ttoomat/work-2026-itmo/README.md

# work-2026-itmo
The first project: DNA synthesiser, power board.

Class B & class D amplifier AI schematics added. Task: remake it manually & start PCB.
