ttoomat/work-2026-itmo/DNA/class_B/LTspice/readme.txt

Draft 1 - для проекта по принтеру ДНК.

Делаю усилитель B класса. Сначала сказано промоделировать с идеальным ОУ в первом
каскаде, подать нужной формы сигнал на вход и посмотреть, какие токи будут в 
выходном каскаде.

Итак, Draft 1 - это просто для ВАХ.

Draft 2 - полная схема усилителя класса B. Точно правильно работает первый каскад. V_IN: [0, 2.5V], V_OUT: [-4.11, 4.13] - усиление в 3.3 раза. V_REF=5V. Добавлен компенсирующий конденсатор, фильтр.

При моделировании с реальным сигналом компенсирующий конденсатор из ООС пришлось удалить. Входной сигнал берётся из файла signal_pwl.txt

Draft 3 - инвертирующий усилитель на транзисторе (для проверки, правильно ли работает LTSpice).
