ttoomat/work-2026-itmo/DNA/class_B/AI/preview/04.png

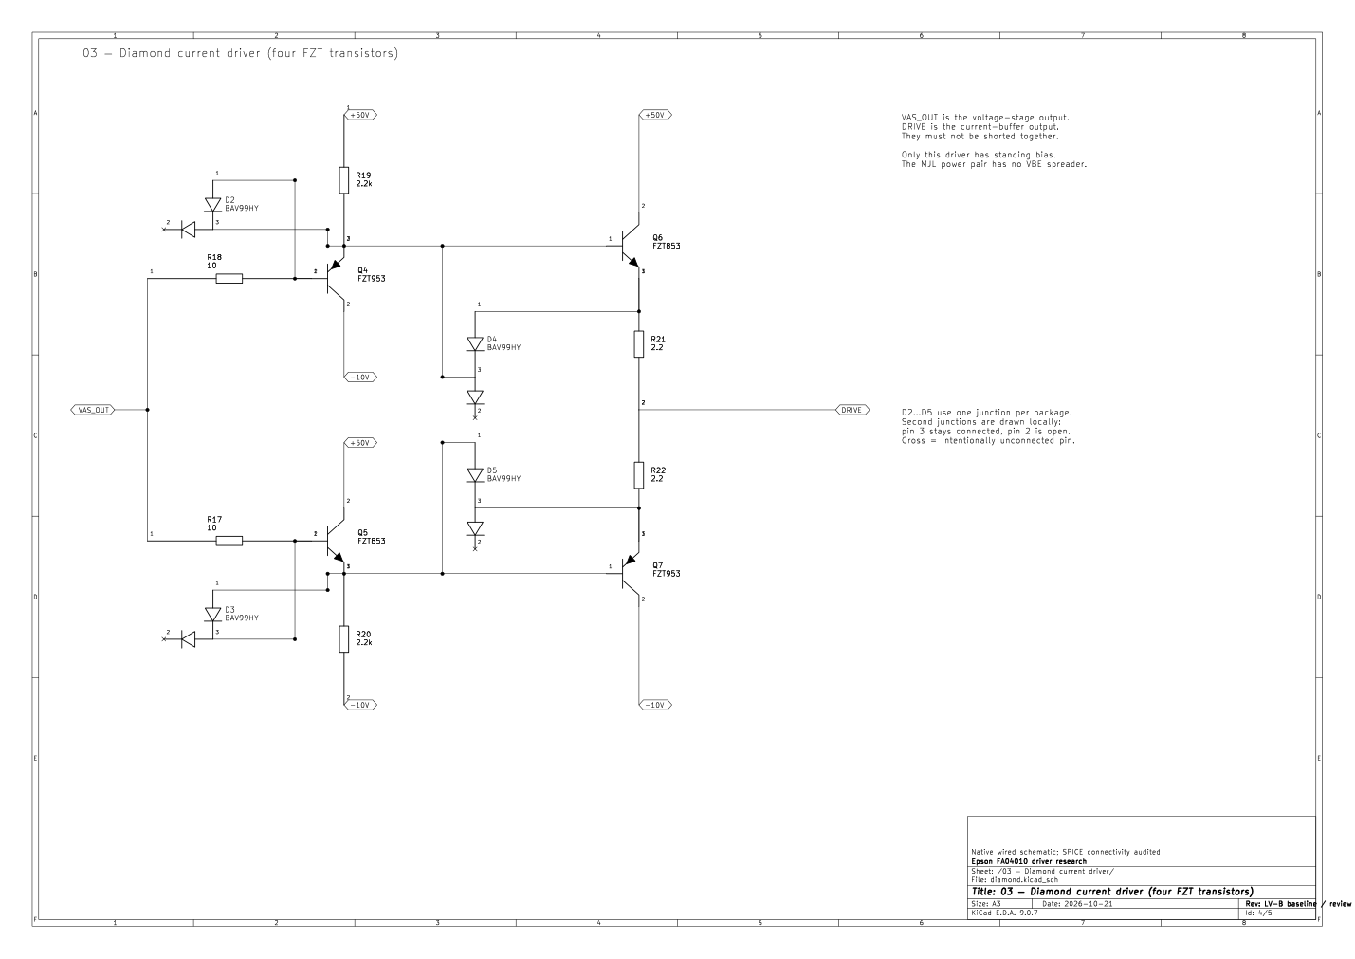
DNA/class_B/AI/preview/04.png
