ttoomat/work-2026-itmo/DNA/class_B/AI/spice/last_pulse.png

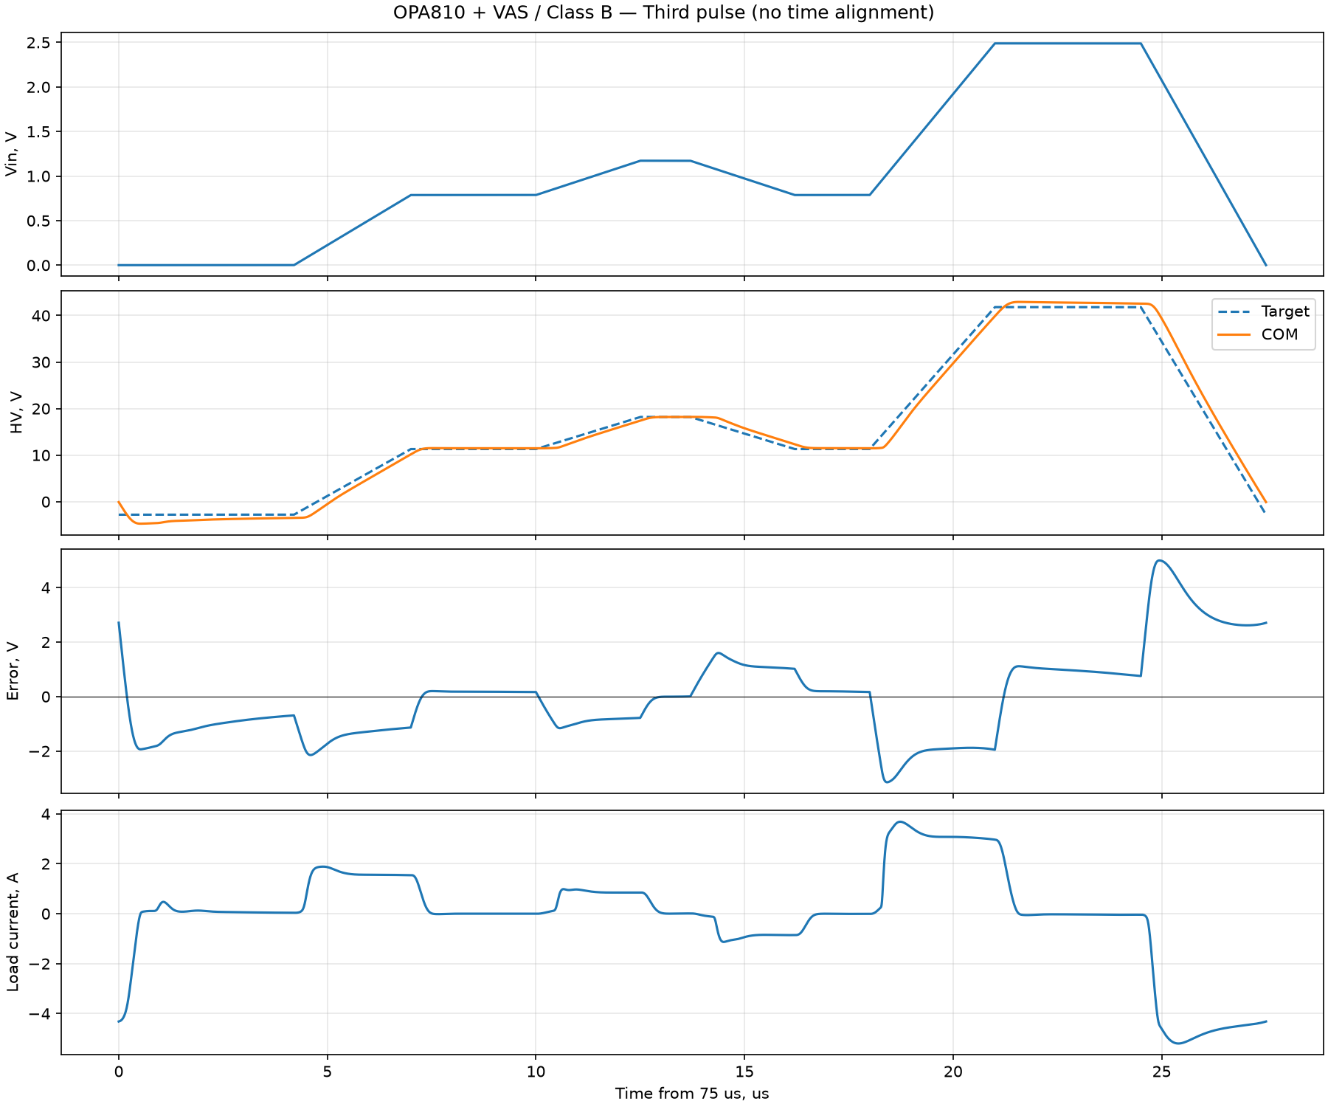
DNA/class_B/AI/spice/last_pulse.png
