ttoomat/work-2026-itmo/DNA/class_B/AI/components.csv

reference | value | footprint | spice_names | sheets | notes
J1 | HV SUPPLY |  |  | 1 | External interface; connector selection pending
J2 | LV SUPPLY |  |  | 1 | External interface; connector selection pending
J3 | VIN + REFERENCE |  |  | 1 | External interface; connector selection pending
J4 | COM OUTPUT |  |  | 1 | External interface; connector selection pending
C4 | 100n |  | C1 | 1
C5 | 100n |  | C2 | 1
C1 | 100n |  | CLVP | 1
C2 | 100n |  | CLVN | 1
U1 | OPA810IDBVR | Package_TO_SOT_SMD:SOT-23-5 | XU1 | 2
R1 | 100 |  | R1 | 2
R6 | 330 |  | RLOCAL | 2
C3 | 4.7n |  | CLOCAL | 2
R7 | 1Meg |  | RLOCALDC | 2
U2 | OPA810IDBVR | Package_TO_SOT_SMD:SOT-23-5 | XFB | 2
R27 | 100 |  | RDIFF | 2
R28 | 330 |  | RDIFFM | 2
C7 | 4.7n |  | CDIFF | 2
R29 | 1Meg |  | RDIFFDC | 2
R14 | 16.92k |  | R3 | 2
R15 | 1k |  | R4 | 2
C8 | 1n |  | CDFC | 2
R30 | 470 |  | RDFC | 2
C9 | 16.92n |  | CLEAD | 2
R31 | 27.7778 |  | RLEAD | 2
D1 | BAV99HY | Package_TO_SOT_SMD:SOT-23 | DCSREF1;DCSREF2 | 3
Q2 | FZT953 | Package_TO_SOT_SMD:SOT-223-3_TabPin2 | QCS | 3
R5 | 82 |  | RCS_EMITTER | 3
R4 | 11k |  | RCSREF | 3
R2 | 47 |  | RVB | 3
Q1 | 2N5551 | Package_TO_SOT_THT:TO-92_Inline | QVAS | 3
R3 | 150 |  | RVE | 3
D12 | BAT46WJ | Diode_SMD:D_SOD-323F | DBAKER | 3
Q3 | 2N5551 | Package_TO_SOT_THT:TO-92_Inline | QVASLIMIT | 3
R32 | 4.7k |  | RVAS_SENSE | 3
R33 | 1k |  | RVAS_SENSE0 | 3
R18 | 10 |  | RHBP | 4
Q4 | FZT953 | Package_TO_SOT_SMD:SOT-223-3_TabPin2 | QHINP | 4
R17 | 10 |  | RHBN | 4
Q5 | FZT853 | Package_TO_SOT_SMD:SOT-223-3_TabPin2 | QHINN | 4
R19 | 2.2k |  | RHBIASP | 4
R20 | 2.2k |  | RHBIASN | 4
Q6 | FZT853 | Package_TO_SOT_SMD:SOT-223-3_TabPin2 | QHOUTN | 4
Q7 | FZT953 | Package_TO_SOT_SMD:SOT-223-3_TabPin2 | QHOUTP | 4
R21 | 2.2 |  | RHEN | 4
R22 | 2.2 |  | RHEP | 4
D2 | BAV99HY | Package_TO_SOT_SMD:SOT-23 | DHCLIP | 4
D3 | BAV99HY | Package_TO_SOT_SMD:SOT-23 | DHCLIN | 4
D4 | BAV99HY | Package_TO_SOT_SMD:SOT-23 | DHCLON | 4
D5 | BAV99HY | Package_TO_SOT_SMD:SOT-23 | DHCLOP | 4
R8 | 4.7 |  | RBASE_N | 5
Q8 | MJL3281A | Package_TO_SOT_THT:TO-264-3_Vertical | QN | 5
R9 | 4.7 |  | RBASE_P | 5
Q9 | MJL1302A | Package_TO_SOT_THT:TO-264-3_Vertical | QP | 5
R10 | 0.22 |  | REN | 5
R11 | 0.22 |  | REP | 5
R12 | 22 |  | RZERO | 5
L1 | 100n / DCR 20m |  | LRF | 5 | 100 nH with 20 mOhm simulated DCR; RCOIL absorbed into inductor
R13 | 0.47 |  | RSHUNT | 5
Q10 | 2N5551 | Package_TO_SOT_THT:TO-92_Inline | QLIMN | 5
R23 | 2.2 |  | RLIMBN | 5
R25 | 10 |  | RLSHN | 5
D6 | BAV99HY | Package_TO_SOT_SMD:SOT-23 | DLIDN | 5
Q11 | 2N5401 | Package_TO_SOT_THT:TO-92_Inline | QLIMP | 5
R24 | 2.2 |  | RLIMBP | 5
R26 | 10 |  | RLSHP | 5
D7 | BAV99HY | Package_TO_SOT_SMD:SOT-23 | DLIDP | 5
D8 | BAV99HY | Package_TO_SOT_SMD:SOT-23 | DCLON;DCLON2 | 5
D9 | BAV99HY | Package_TO_SOT_SMD:SOT-23 | DCLON3;DCLON4 | 5
D10 | BAV99HY | Package_TO_SOT_SMD:SOT-23 | DCLOP4;DCLOP3 | 5
D11 | BAV99HY | Package_TO_SOT_SMD:SOT-23 | DCLOP2;DCLOP | 5
C6 | 300n / TEST |  | C3 | 1 | External dummy load, not driver PCB
R16 | 100k / TEST |  | R5 | 1 | External dummy load, not driver PCB
