ttoomat/work-2026-itmo/DNA/class_D/reference/bom.csv

References | Quantity | Function | Manufacturer | MPN | Package | Value_Rating | Supplier | Supplier_Code | Unit_USD_at_small_quantity | Price_break_qty | Stock_seen | Source_URL | Selection_status | KiCad_References | KiCad_Footprints
U1 | 1 | Fast error amplifier | Texas Instruments | OPA859IDSGR | WSON-8 2x2mm | 5V | DigiKey | 296-51513-1-ND | 5.53 | 1 | 1747 | https://www.digikey.com/en/products/detail/texas-instruments/OPA859IDSGR/9654206 | Selected | U1 | Package_SON:WSON-8-1EP_2x2mm_P0.5mm_EP0.9x1.6mm
U2 | 1 | 8MHz triangle carrier integrator | Texas Instruments | OPA810IDCKR | SC70-5 | 5V | LCSC | C2864510 | 2.9581 | 1 | 988 | https://www.lcsc.com/product-image/C2864510.html | Fixed PWM candidate; no servo integrator | U2 | Package_TO_SOT_SMD:SOT-353_SC-70-5
U4 | 1 | PWM comparator external hysteresis | Texas Instruments | TLV3603DCKR | SC70-6 | 5V | LCSC | C5213955 | 4.0479 | 1 | 33 | https://www.lcsc.com/product-image/C5213955.html | Selected | U4 | Package_TO_SOT_SMD:SOT-363_SC-70-6
U5 | 1 | Half bridge driver | Texas Instruments | LMG1210RVRT | WQFN-19 3x4mm | External 5V VIN=VDD | LCSC | C2862667 | 7.0419 | 1 | 99 | https://www.lcsc.com/product-detail/C2862667.html | Selected | U5 | COM:LMG1210_RVR19
U6 | 1 | High impedance input and level shifting | Texas Instruments | OPA2192IDR | SOIC-8 | +5V system / -10V system | LCSC | C110074 | 1.1943 | 1 | 33661 | https://www.lcsc.com/product-image/C110074.html | Selected calibration required | U6 | Package_SO:SOIC-8_3.9x4.9mm_P1.27mm
U7 | 1 | 3.3V reference and 1.65V bias | Texas Instruments | REF2033AIDDCR | SOT23-THIN-5 | Local 5V supply | DigiKey | 296-46177-1-ND | 4.61 | 1 | 11380 | https://www.digikey.com/en/products/detail/texas-instruments/REF2033AIDDCR/5004870 | Selected | U7 | Package_TO_SOT_SMD:SOT-23-5
U8 | 1 | Local 5V rail referenced to -10V | Texas Instruments | TLV76750DRVR | WSON-6 2x2mm | 16V input 1A output | DigiKey | 296-TLV76750DRVRCT-ND | 1.05 | 1 | 1624 | https://www.digikey.com/en/products/detail/texas-instruments/TLV76750DRVR/10820367 | Supply checks pending | U8 | Package_SON:WSON-6-1EP_2x2mm_P0.65mm_EP1x1.6mm_ThermalVias
U9 | 1 | +5V system input-stage supply | Texas Instruments | TPS7A1650DRBR | VSON-8 3x3mm | 60V input 100mA output | DigiKey | TPS7A1650DRBR | 4.12 | 1 | 336 | https://www.digikey.com/en/products/detail/texas-instruments/TPS7A1650DRBR/5031609 | Supply checks pending | U9 | Package_SON:VSON-8-1EP_3x3mm_P0.65mm_EP1.65x2.4mm
U10 | 1 | EN CLOCK8MHz RUN forward; effective driver READY return | Texas Instruments | ISO7741FDBQR | SSOP-16 | 3.3V FPGA side / local 5V | LCSC | C2872241 | 2.6395 | 1 | 36 | https://www.lcsc.com/product-image/C2872241.html | Stock checked; control sequencing pending | U10 | Package_SO:QSOP-16_3.9x4.9mm_P0.635mm
U11 | 1 | PWM/RUN AND gate; second gate unused in base prototype | Texas Instruments | SN74LVC2G08DCTR | SM8 DCT | Local 5V | LCSC | C352973 | 0.3431 | 5 | 33530 | https://www.lcsc.com/product-image/C352973.html | Stock checked; different package from original DCU proposal | U11 | COM:TI_DCT8
Q1,Q2 | 2 | Power GaN half bridge | EPC | EPC2214 | Die 1.35x1.35mm | 80V 10A continuous 60A pulse10us | DigiKey | 917-1213-1-ND | 2.83 | 1 | 29150 cached snapshot | https://www.digikey.com/en/products/detail/epc/EPC2214/9586556 | Vendor model completed at1/300nF; calibration verification pending; layout and cooling required | Q1,Q2 | PENDING
L1 | 1 | Low loss main output inductor | Coilcraft | 2929SQ-501JEC | 14.1x7.49x7.24mm | 500nH 5% air core | Newark | 69W5865 |  |  | 36 cached snapshot | https://canada.newark.com/coilcraft/2929sq-501jec/inductor-500nh-5-485mhz-rf-smd/dp/69W5865 | 500nH candidate; DC resistance16.5mOhm; RF copper heating not validated | L1 | Inductor_SMD:L_Coilcraft_2929SQ-501
CF1,CF2,CF3,CF4 | 4 | Output filter capacitance | Murata | GRM31C5C2A104JA01L | 1206 | 100nF 100V C0G 5% | LCSC | C405303 | 0.4028 | 5 | 16000 | https://www.lcsc.com/product-detail/C405303.html | Single-stage 468nF bank candidate; not frozen | C1,C2,C3,C4 | Capacitor_SMD:C_1206_3216Metric
CF5 | 1 | Output filter bank trim | Murata | GRM31C5C2A683JA01L | 1206 | 68nF 100V C0G 5% | LCSC | C711038 | 0.3674 | 5 | 285 | https://www.lcsc.com/product-detail/C711038.html | Single-stage 468nF bank candidate; not frozen | C5 | Capacitor_SMD:C_1206_3216Metric
RdampA,RdampB | 2 | Main LC series damping | Susumu | KRL3264E-C-R220-F-T1 | 2512 | 0.22ohm 1% 3W each; parallel equivalent0.11ohm | DigiKey | 408-KRL3264E-C-R220-F-T1CT-ND | 0.90 | 1 | 2592 cached snapshot | https://www.digikey.com/en/products/detail/susumu/KRL3264E-C-R220-F-T1/21510412 | About1.15W each in300nF nominal model; PCB thermal derating required | R1,R2 | Resistor_SMD:R_2512_6332Metric
Rcable | 1 | Intentional output damping; not FPC resistance | Susumu | KRL3264E-C-R220-F-T1 | 2512 | 0.22 ohm 1% 3W | DigiKey | 408-KRL3264E-C-R220-F-T1CT-ND | 0.90 | 1 | 2592 cached snapshot | https://www.digikey.com/en/products/detail/susumu/KRL3264E-C-R220-F-T1/21510412 | About0.68W in300nF nominal model; intentional output damping | R3 | Resistor_SMD:R_2512_6332Metric
Dboot | 1 | Driver external bootstrap diode | Nexperia | BAT46WJ,115 | SOD323F | 100V Schottky |  |  |  |  |  | https://www.nexperia.com/product/BAT46WJ | Vendor model tested; stock refresh pending | D1 | Diode_SMD:D_SOD-323F
Rfp,Rfn | 2 | Input level shifter | Yageo | RT0603BRD0710KL | 0603 | 10k ohm 0.1% 0.1W |  |  |  |  |  |  | Candidate; stock/price not yet verified | R4,R5 | Resistor_SMD:R_0603_1608Metric
Rfg1,Rffb1 | 2 | Input level shifter | Yageo | RT0603BRD075K9L | 0603 | 5.90k ohm 0.1% 0.1W |  |  |  |  |  |  | Candidate; stock/price not yet verified | R6,R7 | Resistor_SMD:R_0603_1608Metric
Rfg2 | 1 | Input level shifter | Yageo | RT0603BRD0782R5L | 0603 | 82.5 ohm 0.1% 0.1W |  |  |  |  |  |  | Candidate; stock/price not yet verified | R8 | Resistor_SMD:R_0603_1608Metric
Rfm1 | 1 | Input level shifter | Yageo | RT0603BRD0773K2L | 0603 | 73.2k ohm 0.1% 0.1W |  |  |  |  |  |  | Candidate; stock/price not yet verified | R9 | Resistor_SMD:R_0603_1608Metric
Rfm2 | 1 | Input level shifter | Yageo | RT0603BRD07220RL | 0603 | 220 ohm 0.1% 0.1W |  |  |  |  |  |  | Candidate; stock/price not yet verified | R10 | Resistor_SMD:R_0603_1608Metric
Rffb2 | 1 | Input level shifter | Yageo | RT0603BRD0733R2L | 0603 | 33.2 ohm 0.1% 0.1W |  |  |  |  |  |  | Candidate; stock/price not yet verified | R11 | Resistor_SMD:R_0603_1608Metric
Rghoff,Rgloff | 2 | Gate pull down | Yageo | RC0603FR-0710KL | 0603 | 10k ohm 1% 0.1W |  |  |  |  |  |  | Candidate; stock/price not yet verified | R12,R13 | Resistor_SMD:R_0603_1608Metric
Rpwm | 1 | PWM input series | Yageo | RC0603FR-0733RL | 0603 | 33 ohm 1% 0.1W |  |  |  |  |  |  | Candidate; stock/price not yet verified | R14 | Resistor_SMD:R_0603_1608Metric
Rcmp | 1 | Comparator load | Yageo | RC0603FR-0710KL | 0603 | 10k ohm 1% 0.1W |  |  |  |  |  |  | Candidate; stock/price not yet verified | R15 | Resistor_SMD:R_0603_1608Metric
Rdhl,Rdlh | 2 | LMG1210 deadtime setting; nominal7.2ns | Yageo | RC0603FR-07100KL | 0603 | 100k ohm 1% 0.1W |  |  |  |  |  |  | Candidate; stock/price not yet verified | R16,R17 | Resistor_SMD:R_0603_1608Metric
RpullEN,RpullCLK,RpullRUN | 3 | Control input default low | Yageo | RC0603FR-07100KL | 0603 | 100k ohm 1% 0.1W |  |  |  |  |  |  | Candidate; stock/price not yet verified | R18,R19,R20 | Resistor_SMD:R_0603_1608Metric
Ccmp | 1 | Lead node HF shunt to MID | Murata | GRM1885C1H2R0CA01D | 0603 | 2pF 50V C0G |  |  |  |  |  |  | Candidate; stock/price not yet verified | C6 | Capacitor_SMD:C_0603_1608Metric
Cpwm | 1 | PWM input | Murata | GRM1885C1H3R0CA01D | 0603 | 3pF 50V C0G |  |  |  |  |  |  | Candidate; stock/price not yet verified | C7 | Capacitor_SMD:C_0603_1608Metric
Cinput | 1 | Input RC | Murata | GRM1885C1H470JA01D | 0603 | 47pF 50V C0G |  |  |  |  |  |  | Candidate; stock/price not yet verified | C8 | Capacitor_SMD:C_0603_1608Metric
Rshunt | 1 | Coil-current measurement shunt; no automatic current trip in base prototype | Vishay | WSLP2512R0010FEA | 2512 | 1mOhm 1% 3W |  |  |  |  |  |  | Candidate gain50 current monitor; ordering status and parasitics pending | R21 | Resistor_SMD:R_2512_6332Metric
Cpos_bulk1,Cpos_bulk2 | 2 | Bus pulse energy buffering | Cornell Dubilier Knowles | 476AVG100MGBJ | Radial D10mm H13.5mm max pitch5mm | 47uF 100V polymer 38mOhm 2.1A at100kHz each | DigiKey | 1572-1734-ND | 4.03 | 1 | 7470 | https://www.digikey.com/en/products/detail/cornell-dubilier-knowles/476AVG100MGBJ/5412750 | Candidate across BUS to system GND; ESR and biased MLCC sharing still to verify | C9,C10 | Capacitor_THT:CP_Radial_D10.0mm_P5.00mm
Cbus_HF1,Cbus_HF2,Cbus_HF3,Cbus_HF4 | 4 | Upstream bus MLCC bank; separate from the local20nF damped branch | KEMET | C1210C225K1RACTU | 1210 | 2.2uF 100V X7R nominal | DigiKey | C1210C225K1RACTU | 1.09 | 1 | 215441 | https://www.digikey.com/en/products/detail/kemet/C1210C225K1RACTU/1950671 | Active and stocked; DC-bias capacitance/ripple sharing not yet verified | C11,C12,C13,C14 | Capacitor_SMD:C_1210_3225Metric
Cdec_U1,Cdec_U2,Cdec_U4,Cdec_U6p,Cdec_U6n,Cdec_U7,Cdec_U10A,Cdec_U10B,Cdec_U11 | 9 | One local bypass per IC supply; two for isolator | Murata | GRM188R71H104KA93D | 0603 | 100nF 50V X7R |  |  |  |  |  |  | Candidate; stock/price not yet verified | C15,C16,C17,C18,C19,C20,C21,C22,C23 | Capacitor_SMD:C_0603_1608Metric
Cldo8in,Cldo8out,Cldo9out,Caux | 4 | Auxiliary supply decoupling | Murata | GRM21BR71E475KA73L | 0805 | 4.7uF 25V X7R nominal |  |  |  |  |  |  | Candidate; regulator minimum effective capacitance must be checked | C24,C25,C26,C27 | Capacitor_SMD:C_0805_2012Metric
Cldo9in | 1 | High voltage input LDO bypass | KEMET | C1210C105K1RACTU | 1210 | 1uF 100V X7R nominal |  |  |  |  |  |  | Candidate; stock and effective capacitance pending | C28 | Capacitor_SMD:C_1210_3225Metric
Jpower | 1 | Power entry +50V/GND/-10V | Wurth Elektronik | 691311500003 | Through hole 3P 5.08mm vertical | 300V 20A header; pin1 +50V pin2 GND pin3 -10V | DigiKey | 691311500003 | 0.57 | 1 | 420 | https://www.digikey.com/en/products/detail/w%C3%BCrth-elektronik/691311500003/2060549 | Selected; mating cable plug 691351500003 | J1 | PENDING
Jcontrol | 1 | VIN GND 3V3 EN CLOCK8MHz RUN READY | Wurth Elektronik | 61300821121 | 2x4 2.54mm vertical through hole | 8-contact header; pins1GND 2VIN 3FPGA3V3 4GND 5EN 6CLOCK 7RUN 8ENABLE_ECHO | Mouser | 710-61300821121 | 0.70 | 1 | 3241 cached | https://www.mouser.com/ProductDetail/Wurth-Elektronik/61300821121?qs=PhR8RmCirEZmTYQilRTqTw%3D%3D | Proposed pinout; READY returns effective driver enable; timing not yet validated | J2 | Connector_PinHeader_2.54mm:PinHeader_2x04_P2.54mm_Vertical
Cref,Cbias | 2 | REF2033 reference and bias output bypass | Murata | GRM188R71C105KA12D | 0603 | 1uF 16V X7R nominal |  |  |  |  |  |  | Candidate; effective capacitance and permitted reference load pending | C29,C30 | Capacitor_SMD:C_0603_1608Metric
Cneg_bulk | 1 | Negative rail energy buffering; positive terminal to system GND | Panasonic | 25SVPF330M | SMD D10mm H12.7mm | 330uF 25V polymer 14mOhm 5A at100kHz | DigiKey | P16512CT-ND | 2.79 | 1 | 7783 | https://www.digikey.com/en/products/detail/panasonic-industry/25SVPF330M/4204844 | Active stocked candidate; connects GND to PGND; frequency derating still to verify | C31 | Capacitor_SMD:CP_Elec_10x12.5
Rplus | 1 | Fixed PWM compensation / scaling | Yageo | RT0603BRD07249RL | 0603 | 249 ohm 0.1% .1W |  |  |  |  |  |  | Candidate; exact stock/price not yet verified | R22 | Resistor_SMD:R_0603_1608Metric
Rbias,Rfb,Rlead | 3 | Fixed PWM compensation / scaling | Yageo | RT0603BRD072K94L | 0603 | 2.94k ohm 0.1% .1W |  |  |  |  |  |  | Candidate; exact stock/price not yet verified | R23,R24,R25 | Resistor_SMD:R_0603_1608Metric
RmeasureA,RmeasureB | 2 | Fixed PWM compensation / scaling | Yageo | RT1206BRD0715KL | 1206 | 15k ohm 0.1% .25W |  |  |  |  |  |  | Candidate; exact stock/price not yet verified | R26,R27 | Resistor_SMD:R_1206_3216Metric
RgainA | 1 | Fixed PWM compensation / scaling | Yageo | RT0603BRD07255RL | 0603 | 255 ohm 0.1% .1W |  |  |  |  |  |  | Candidate; exact stock/price not yet verified | R28 | Resistor_SMD:R_0603_1608Metric
RgainB | 1 | Fine gain leg;1% here contributes only0.01% of the257.55ohm total | Yageo | RC0603FR-072R55L | 0603 | 2.55ohm 1% .1W | DigiKey | 13-RC0603FR-072R55LCT-ND |  |  | 1198 cached | https://www.digikey.com/en/products/detail/yageo/RC0603FR-072R55L/5918323 | Active catalogue part; stock seen; USD unit tier not verified | R29 | Resistor_SMD:R_0603_1608Metric
Rleadr | 1 | Fixed PWM compensation / scaling | Yageo | RT0603BRD07215RL | 0603 | 215 ohm 0.1% .1W |  |  |  |  |  |  | Candidate; exact stock/price not yet verified | R30 | Resistor_SMD:R_0603_1608Metric
Rinput | 1 | Fixed PWM compensation / scaling | Yageo | RT0603BRD07100RL | 0603 | 100 ohm 0.1% .1W |  |  |  |  |  |  | Candidate; exact stock/price not yet verified | R31 | Resistor_SMD:R_0603_1608Metric
Rmixlead | 1 | Fixed PWM compensation / scaling | Yageo | RT0603BRD0713K3L | 0603 | 13.3k ohm 0.1% .1W |  |  |  |  |  |  | Candidate; exact stock/price not yet verified | R32 | Resistor_SMD:R_0603_1608Metric
Rmixref | 1 | Fixed PWM compensation / scaling | Yageo | RT0603BRD07100KL | 0603 | 100k ohm 0.1% .1W |  |  |  |  |  |  | Candidate; exact stock/price not yet verified | R33 | Resistor_SMD:R_0603_1608Metric
Rmixhi | 1 | Fixed PWM compensation / scaling | Yageo | RT0603BRD07158KL | 0603 | 158k ohm 0.1% .1W |  |  |  |  |  |  | Candidate; exact stock/price not yet verified | R34 | Resistor_SMD:R_0603_1608Metric
Rmixlo | 1 | Fixed PWM compensation / scaling | Yageo | RT0603BRD07113KL | 0603 | 113k ohm 0.1% .1W |  |  |  |  |  |  | Candidate; exact stock/price not yet verified | R35 | Resistor_SMD:R_0603_1608Metric
RclockA | 1 | Fixed PWM compensation / scaling | Yageo | RT0603BRD0714K3L | 0603 | 14.3k ohm 0.1% .1W |  |  |  |  |  |  | Candidate; exact stock/price not yet verified | R36 | Resistor_SMD:R_0603_1608Metric
RclockB | 1 | Fixed PWM compensation / scaling | Yageo | RT0603BRD07169RL | 0603 | 169 ohm 0.1% .1W |  |  |  |  |  |  | Candidate; exact stock/price not yet verified | R37 | Resistor_SMD:R_0603_1608Metric
Rtriangle | 1 | Fixed PWM compensation / scaling | Yageo | RT0603BRD0749K9L | 0603 | 49.9k ohm 0.1% .1W |  |  |  |  |  |  | Candidate; exact stock/price not yet verified | R38 | Resistor_SMD:R_0603_1608Metric
Rhys | 1 | Small defined external comparator hysteresis | Vishay Dale | CRCW0603100MJPTAHR | 0603 | 100Mohm 5% .125W | DigiKey | 541-CRCW0603100MJPTAHRCT-ND | .49 | 1 | 9269 | https://www.digikey.com/en/products/detail/vishay-dale/CRCW0603100MJPTAHR/11500862 | Active and stocked snapshot2026-10-21; input leakage/PCB cleanliness matter | R39 | Resistor_SMD:R_0603_1608Metric
Rgh,Rgl | 2 | GaN gate series | Panasonic | ERJ3RQFR51V | 0603 | 0.51ohm 1% .1W |  |  |  |  |  | https://industrial.panasonic.com/ww/products/pt/current-sensing-chip-resistors/models/ERJ3RQFR51V | Manufacturer part confirmed; vendor full-loop model uses0.51ohm; stock refresh pending | R40,R41 | Resistor_SMD:R_0603_1608Metric
CleadA | 1 | Controller / analogue small-signal capacitor | Murata | GRM1885C1H121JA01D | 0603 | 120pF 50V C0G 5% |  |  |  |  |  |  | Candidate; exact stock/price not yet verified | C32 | Capacitor_SMD:C_0603_1608Metric
CleadB | 1 | Controller / analogue small-signal capacitor | Murata | GRM1885C1H4R7CA01D | 0603 | 4.7pF 50V C0G |  |  |  |  |  |  | Candidate; exact stock/price not yet verified | C33 | Capacitor_SMD:C_0603_1608Metric
Cref_filter | 1 | Controller / analogue small-signal capacitor | Murata | GRM1885C1H162JA01D | 0603 | 1600pF 50V C0G 5% |  |  |  |  |  |  | Candidate; exact stock/price not yet verified | C34 | Capacitor_SMD:C_0603_1608Metric
Cfront_out | 1 | Controller / analogue small-signal capacitor | Murata | GRM1885C1H100JA01D | 0603 | 10pF 50V C0G 5% |  |  |  |  |  |  | Candidate; exact stock/price not yet verified | C35 | Capacitor_SMD:C_0603_1608Metric
CtriangleA | 1 | Carrier integrator; parallel with3pF for54pF | KEMET | C0603C510F5GACTU | 0603 | 51pF 50V C0G 1% |  |  |  |  |  | https://search.kemet.com/download/specsheet/C0603C510F5GACTU | Manufacturer part confirmed; distributor catalogue seen; stock/price refresh pending | C36 | Capacitor_SMD:C_0603_1608Metric
CtriangleB | 1 | Carrier integrator parallel trim | Murata | GRM1885C1H3R0CA01D | 0603 | 3pF 50V C0G |  |  |  |  |  |  | Candidate; exact stock/price not yet verified | C37 | Capacitor_SMD:C_0603_1608Metric
Cclock | 1 | AC coupling of isolated8MHz clock | Murata | GRM188R71C104KA01D | 0603 | 100nF 16V X7R |  |  |  |  |  |  | Candidate; exact stock/price not yet verified | C38 | Capacitor_SMD:C_0603_1608Metric
Cboot | 1 | Increased high-side bootstrap | Murata | GRM21BR71C105KA01L | 0805 | 1uF 16V X7R |  |  |  |  |  |  | Nominal1uF model keepsHB-HS>=4.16V; effective biased capacitance still needs component check | C39 | Capacitor_SMD:C_0805_2012Metric
CdriverA,CdriverB | 2 | LMG1210 localVDD bypass; total9.4uF nominal | Murata | GRM21BR71E475KA73L | 0805 | 4.7uF 25V X7R each |  |  |  |  |  |  | Maintain effective Cdriver/Cboot>=5; nominal aggregate9.4uF model completed | C40,C41 | Capacitor_SMD:C_0805_2012Metric
Clocal1,Clocal2 | 2 | Two local bus RC decouplers; effective total20nF | KEMET | C0805C103J1GECTU | 0805 | 10nF 100V C0G 5% | DigiKey |  | .27 | 1 | 4678 cached | https://www.digikey.com/en/products/detail/kemet/C0805C103J1GECTU/8644543 | Active stocked candidate; each in series with0.1ohm; local loop ESL must be verified after layout | C42,C43 | Capacitor_SMD:C_0805_2012Metric
Rlocal1,Rlocal2 | 2 | Explicit damping of each local10nF bypass branch | Panasonic | ERJ-6BWFR100V | 0805 | 0.1ohm 1% .5W | DigiKey | P17589CT-ND | .59 | 1 | 6939 cached | https://www.digikey.com/en/products/detail/panasonic-industry/ERJ-6BWFR100V/5647622 | Two identical branches equal50mOhm/20nF aggregate in model; about0.18W each at300nF | R42,R43 | Resistor_SMD:R_0805_2012Metric
FAN1 | 1 | Forced cooling; supply is local5V relativePGND | Sunon | MF40100V2-1000U-A99 | 40x40x10mm | 5V 94mA .47W 7CFM free-air | DigiKey | 259-1795-ND | 4.87 | 1 | 10334 cached | https://www.digikey.com/en/products/detail/sunon-fans/MF40100V2-1000U-A99/6198733 | Active stocked candidate; mounted airflow and regulator thermal check required
HS1 | 1 | PCB backside common heat spreader / sink | Fischer Elektronik | ICK S 40 x 40 x 20 | 40x40x20mm | Natural Rth3.5K/W catalogue; forced rating depends airflow | DigiKey Marketplace | 5496-ICKS40x40x20-ND | 7.72 | 2 | 910 cached | https://www.digikey.com/en/products/detail/fischer-elektronik/ICK-S-40-x-40-x-20/26281597 | Active manufacturer stock; MOQ2 at quoted tier; mounting/TIM and PCB spreading not yet validated
TIM1 | 1 | Electrical isolation and heat transfer from PCB backside toHS1 |  |  | Cut to40x40mm | Insulating thermal interface; exact thickness and MPN pending |  |  |  |  |  |  | OPEN selection; do not purchase or assume direct common metal contact to GaN sources
Rfan | 1 | Fan supply noise isolation | Yageo | RC1206FR-071RL | 1206 | 1ohm 1% .25W |  |  |  |  |  |  | Candidate; exact stock/price not yet verified | R44 | Resistor_SMD:R_1206_3216Metric
Cfan | 1 | Fan supply decoupling | Panasonic | EEE1AA470SP | SMD aluminium electrolytic | 47uF 10V; exact package/stock confirmation pending |  |  |  |  |  |  | Candidate; exact stock/price not yet verified | C44 | PENDING
