ttoomat/work-2026-itmo/DNA/class_D/reference/ac_result_notes.txt

AC-результаты пользователя проверены 2026-10-21.

1 нФ: частота единичного усиления 1,51160 МГц; запас фазы 47,4829°.
300 нФ: частота единичного усиления 1,01127 МГц; запас фазы 61,1344°.
Оба RAW покрывают заданный диапазон 1 кГц..3 МГц. Штатное завершение в LOG:
0,400 с / 0,356 с. Новых расчётов агент не запускал.
Графики: loop_gain_vendor_u1.pdf; числа и рабочие точки: одноимённый JSON.

Пересечения фазы -180° в диапазоне нет. Численный запас усиления не определён;
нельзя обозначать его бесконечностью. Видимых отрицательных запасов по фазе
в этих двух усреднённых AC-случаях не обнаружено.

Границы вывода:
- U1 — модель OPA859 производителя; PWM/драйвер/силовой каскад усреднены.
- Задержка 25 нс принята как допущение. Частоты пересечения выше fsw/10;
  усреднение хуже описывает влияние переключений в этой области.
- Сигналы задания AC-заземлены; оценивается возвратное отношение петли,
  не передаточная функция от внешнего VIN до COM.
- Фактическая рабочая точка AC-модели COM = 11,7393 В относительно GND,
  то есть 21,7393 В относительно PGND. Задание соответствовало 11,3 В.
  U1 OUT около 1,6221 В относительно PGND, далеко от шин 0/5 В.
  Статическая ошибка этого усреднённого приближения не заменяет измерения
  плато в полной переходной модели; это не проверка точности уровня.
- Не исследованы все duty, субгармоники, цифровая петля, пуск и плата.

В LOG два источника напряжения для измерения токов макромодели записаны
без явного DC-значения; LTspice принял 0 В. Рабочая точка найдена
Gmin stepping после неудачной прямой итерации. Оба расчёта штатно завершены;
повторный запуск для этих сообщений не требуется.
