ttoomat/work-2026-itmo/DNA/class_B/AI/class_b_lv_schematic.pdf

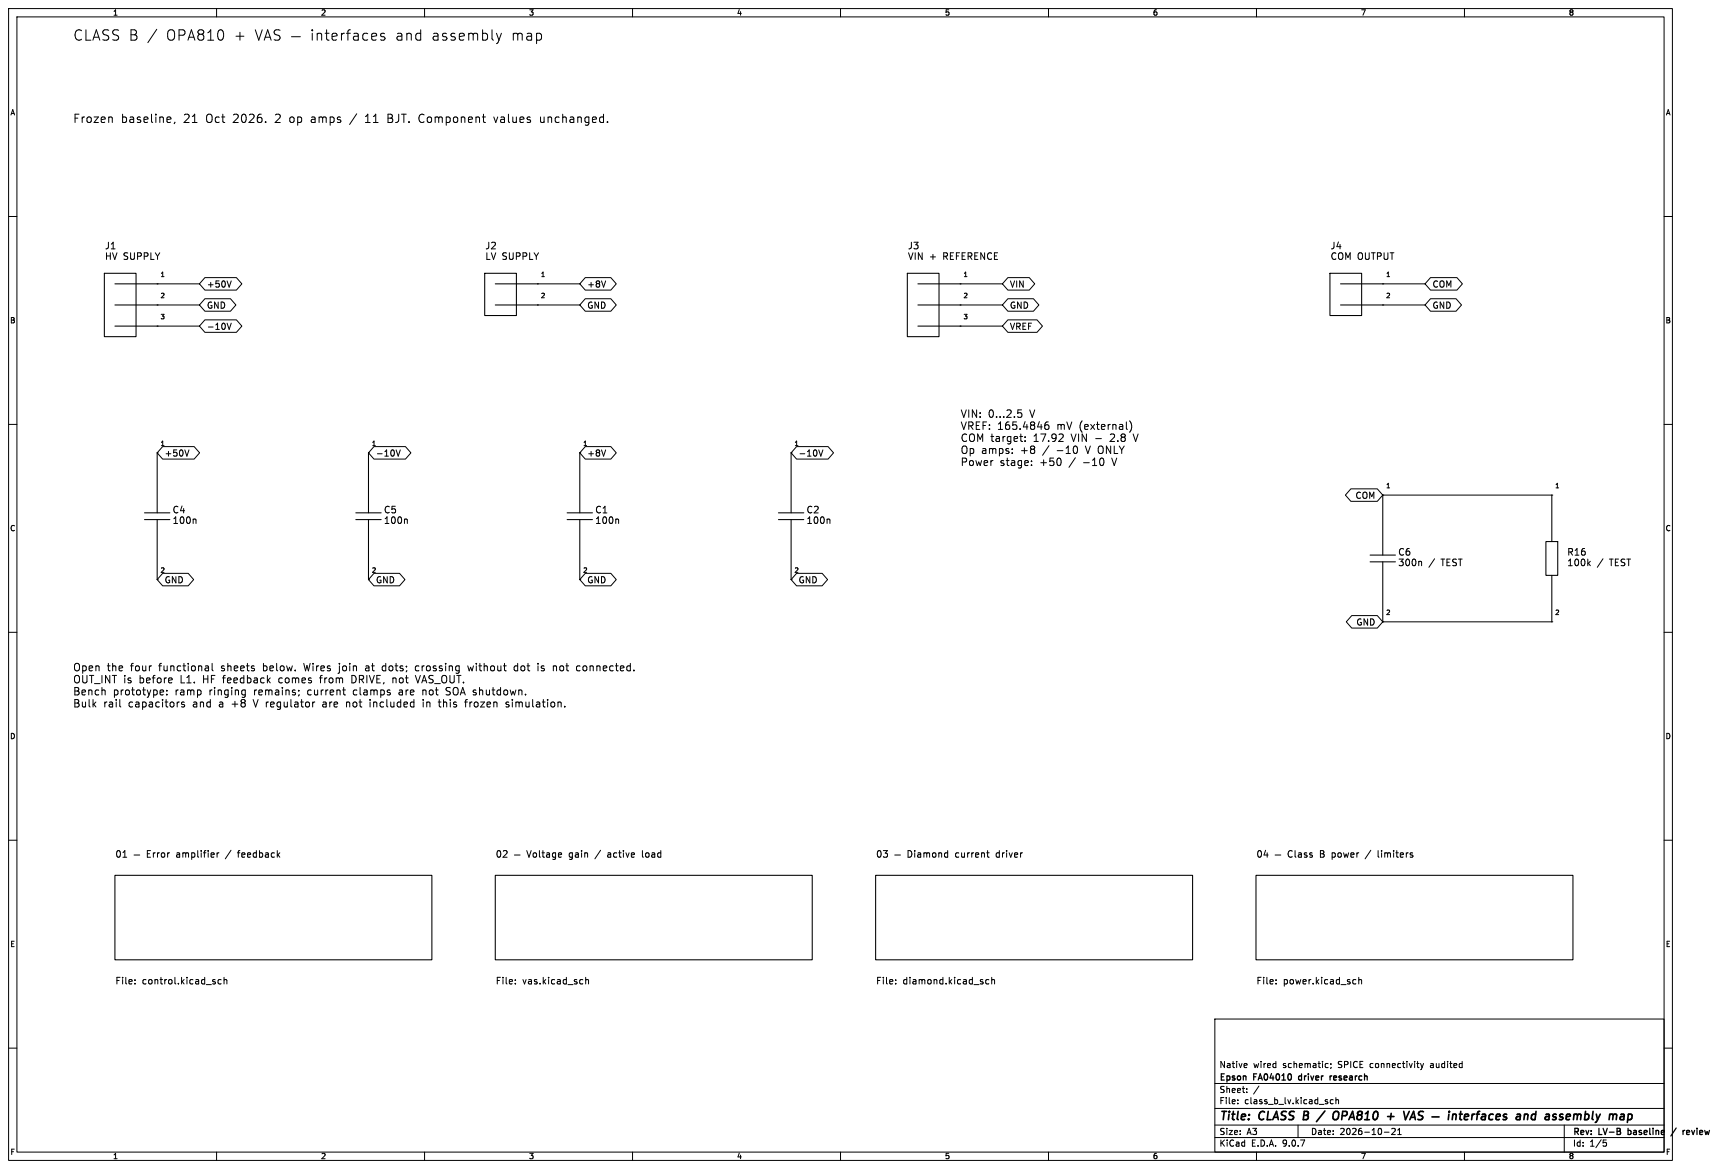
[picture p7: page 1]

Frozen baseline, 21 Oct 2026. 2 op amps / 11 BJT. Component values unchanged.

OUT_INT is before L1. HF feedback comes from DRIVE, not VAS_OUT.

02 þÿ Voltage gain / active load

Id: 1/5 Title: CLASS B / OPA810 + VAS þÿ interfaces and assembly map

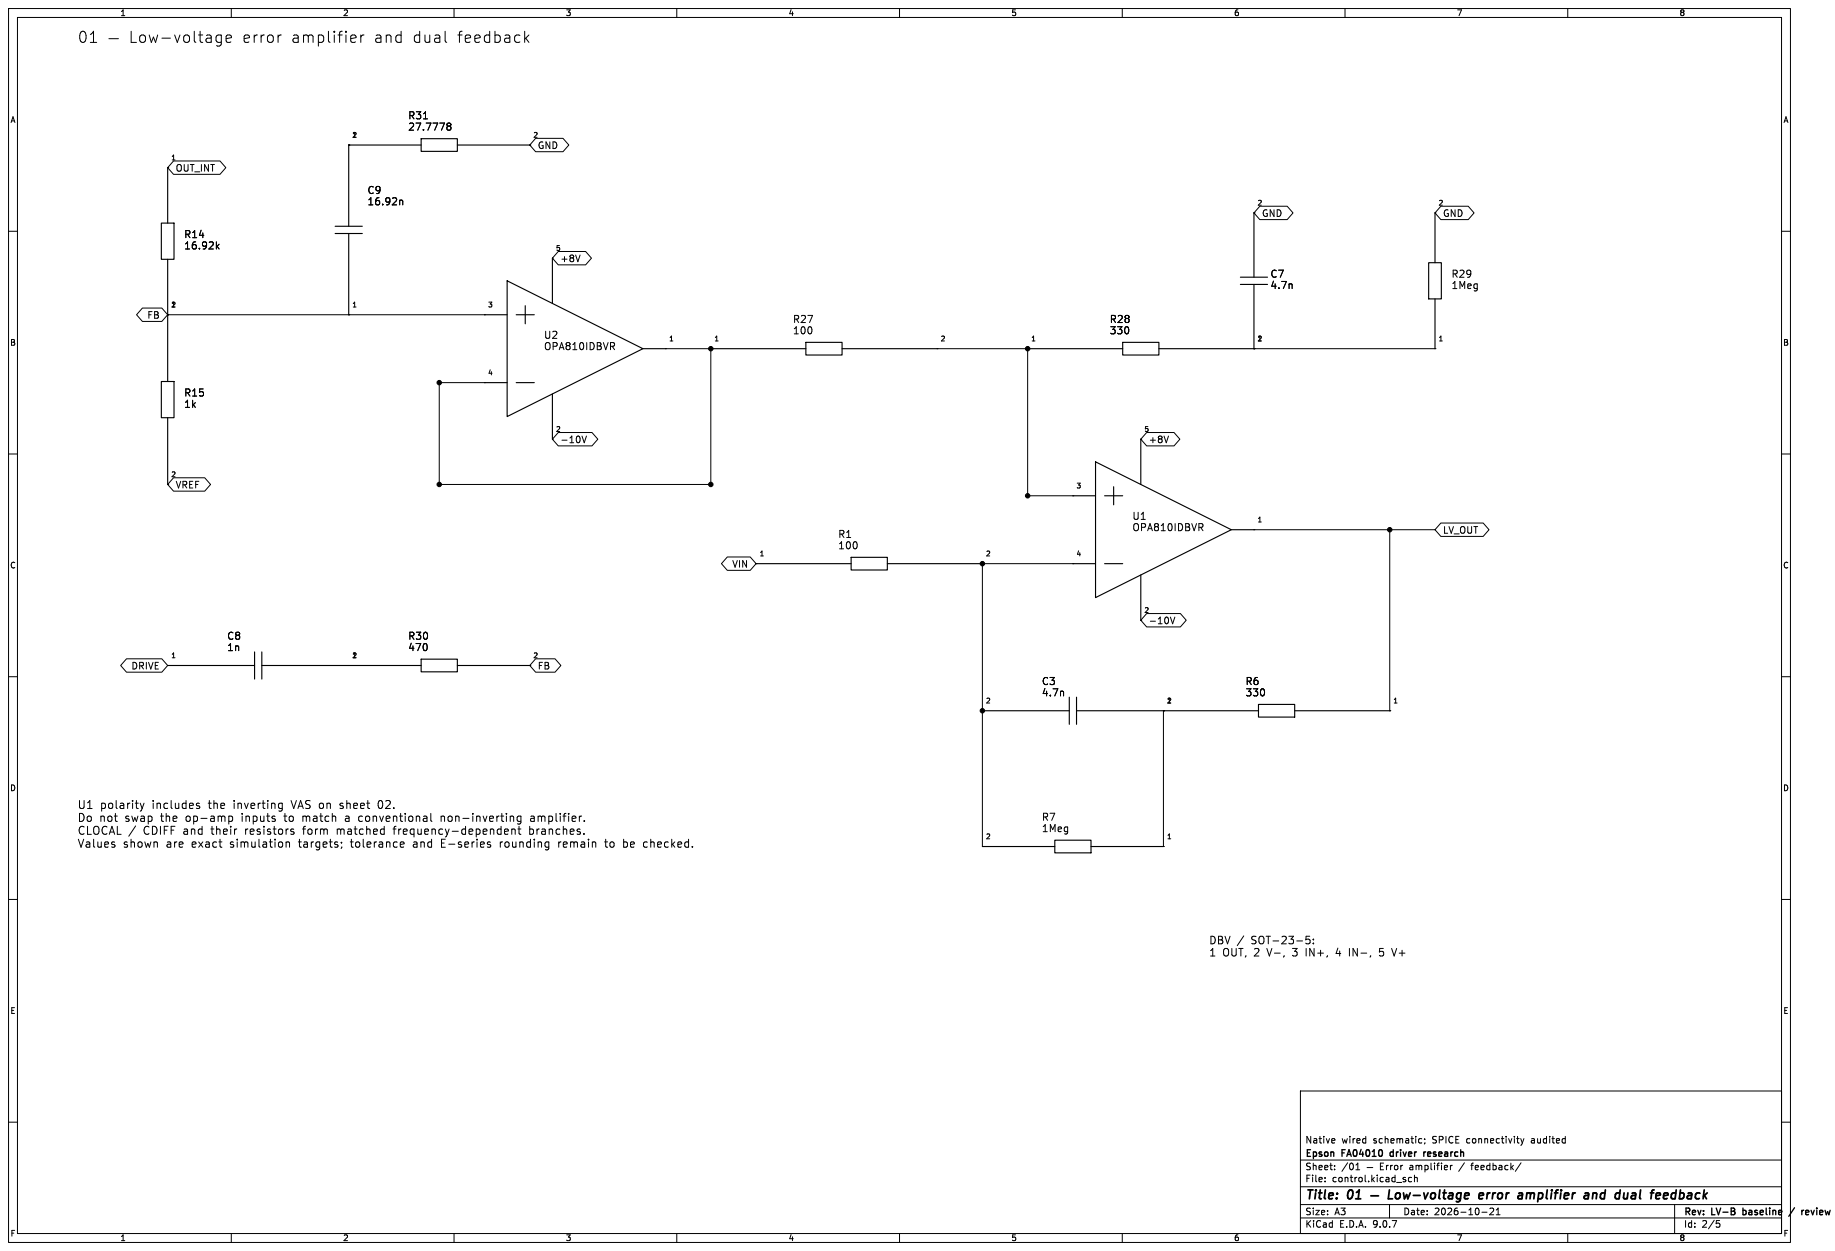
[picture p8: page 2]

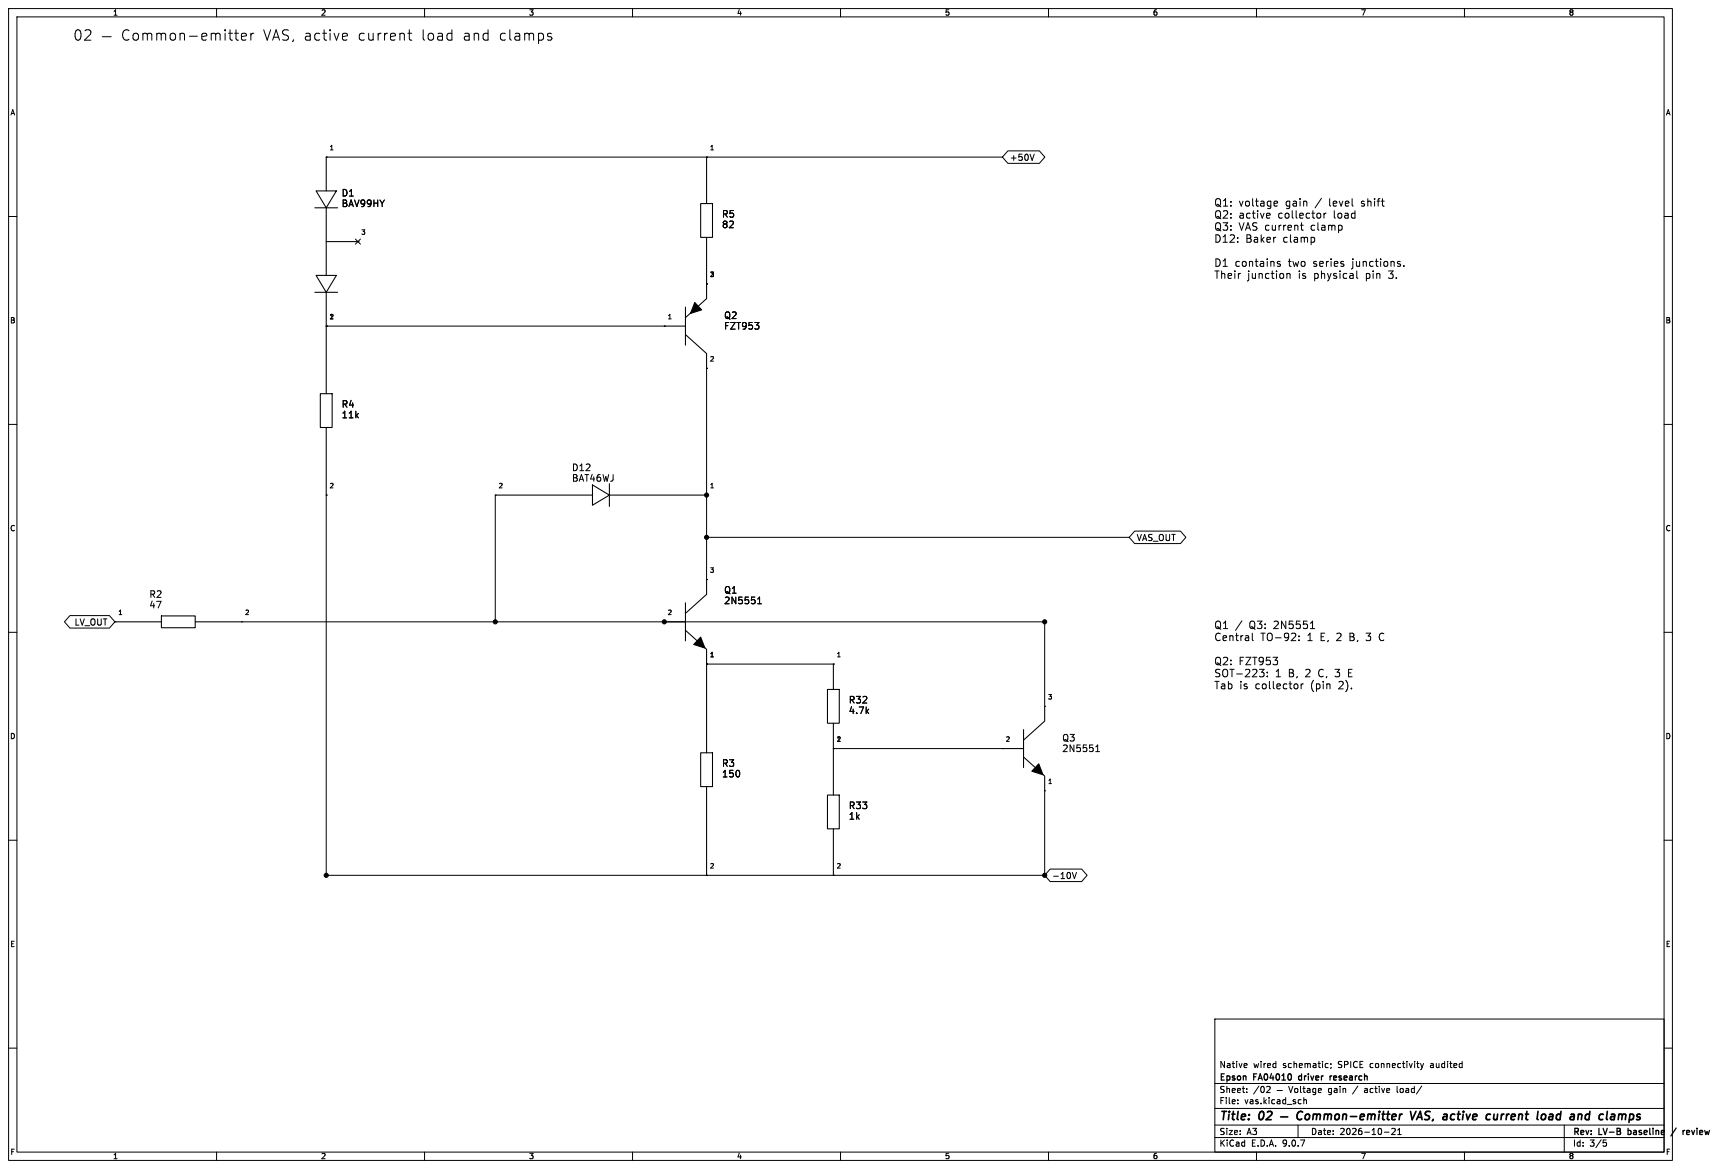
[picture p9: page 3]

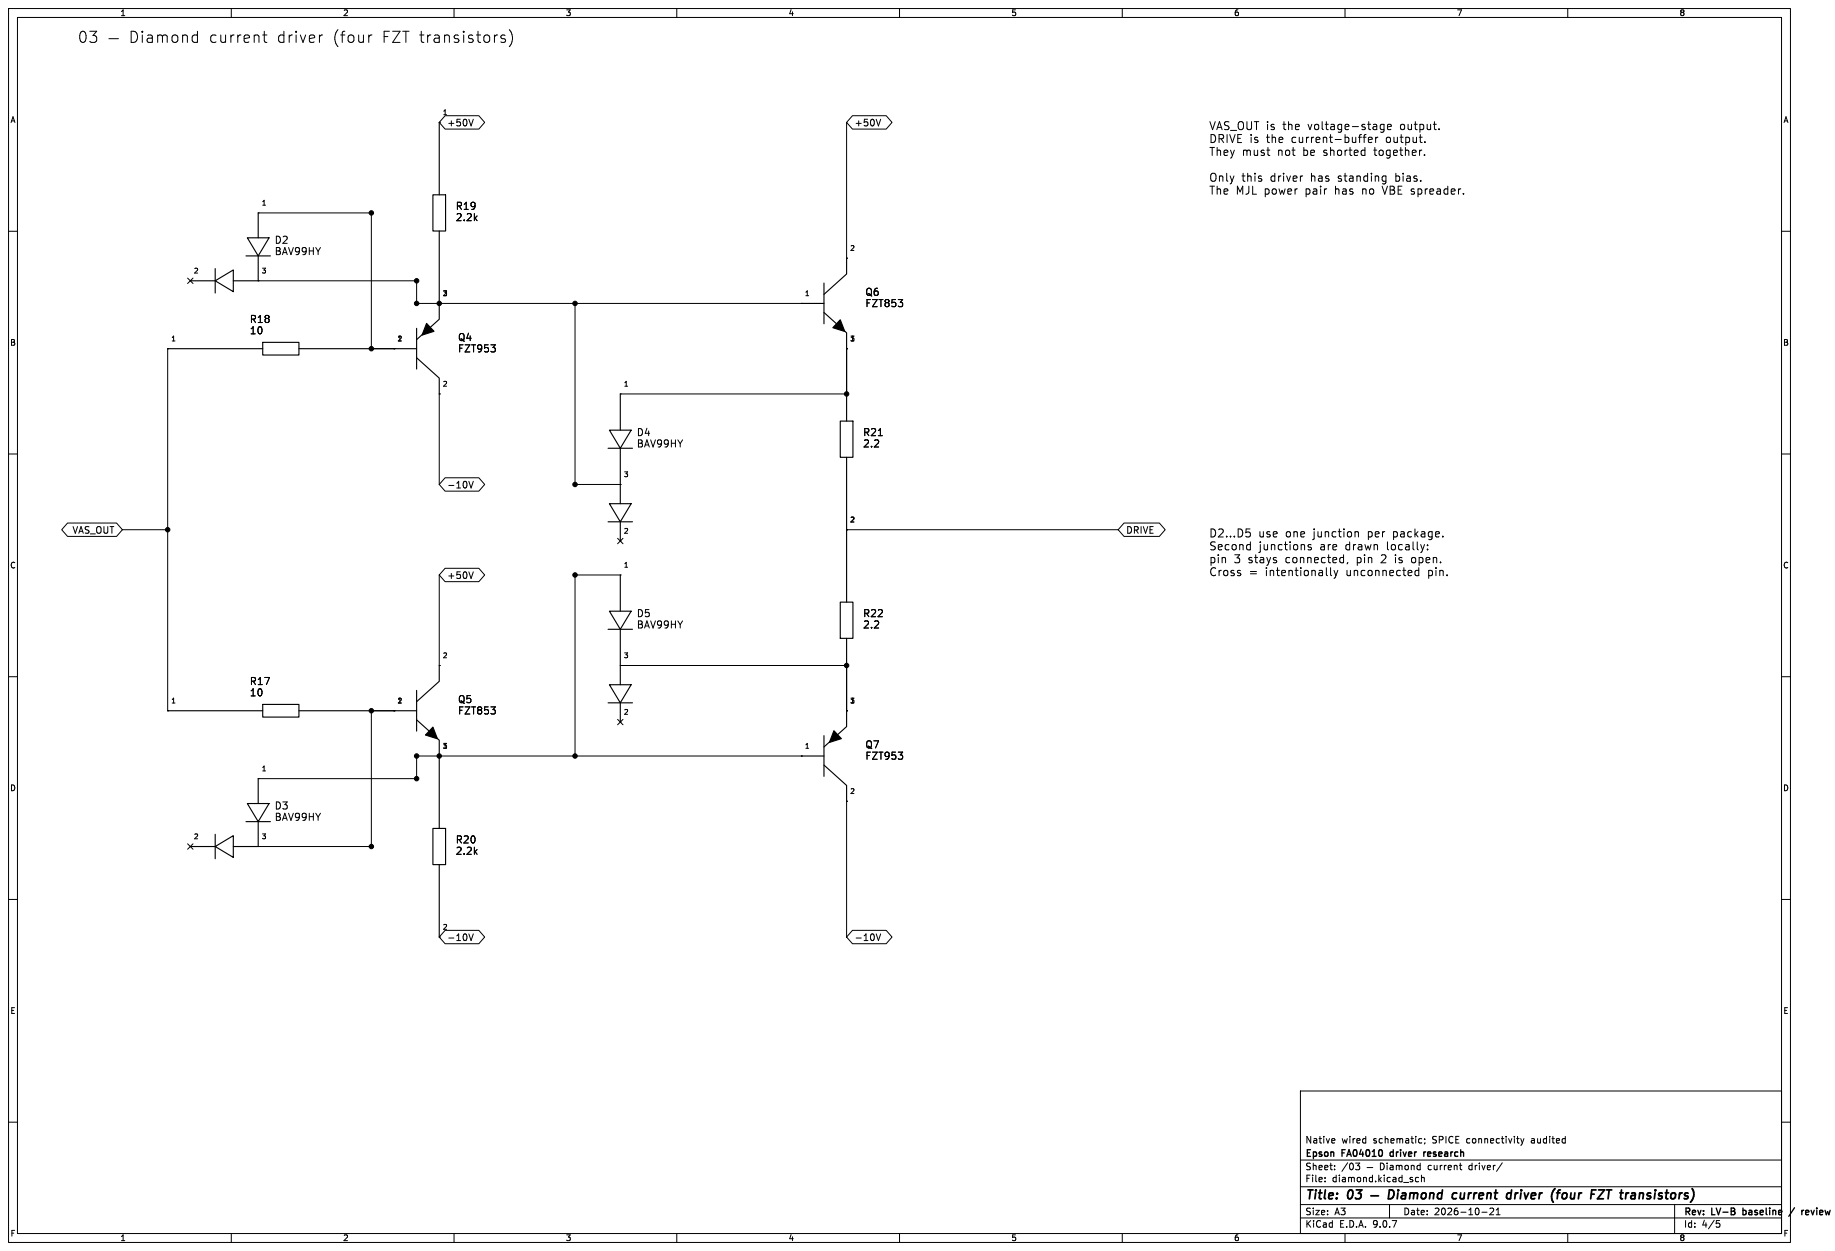
[picture p10: page 4]

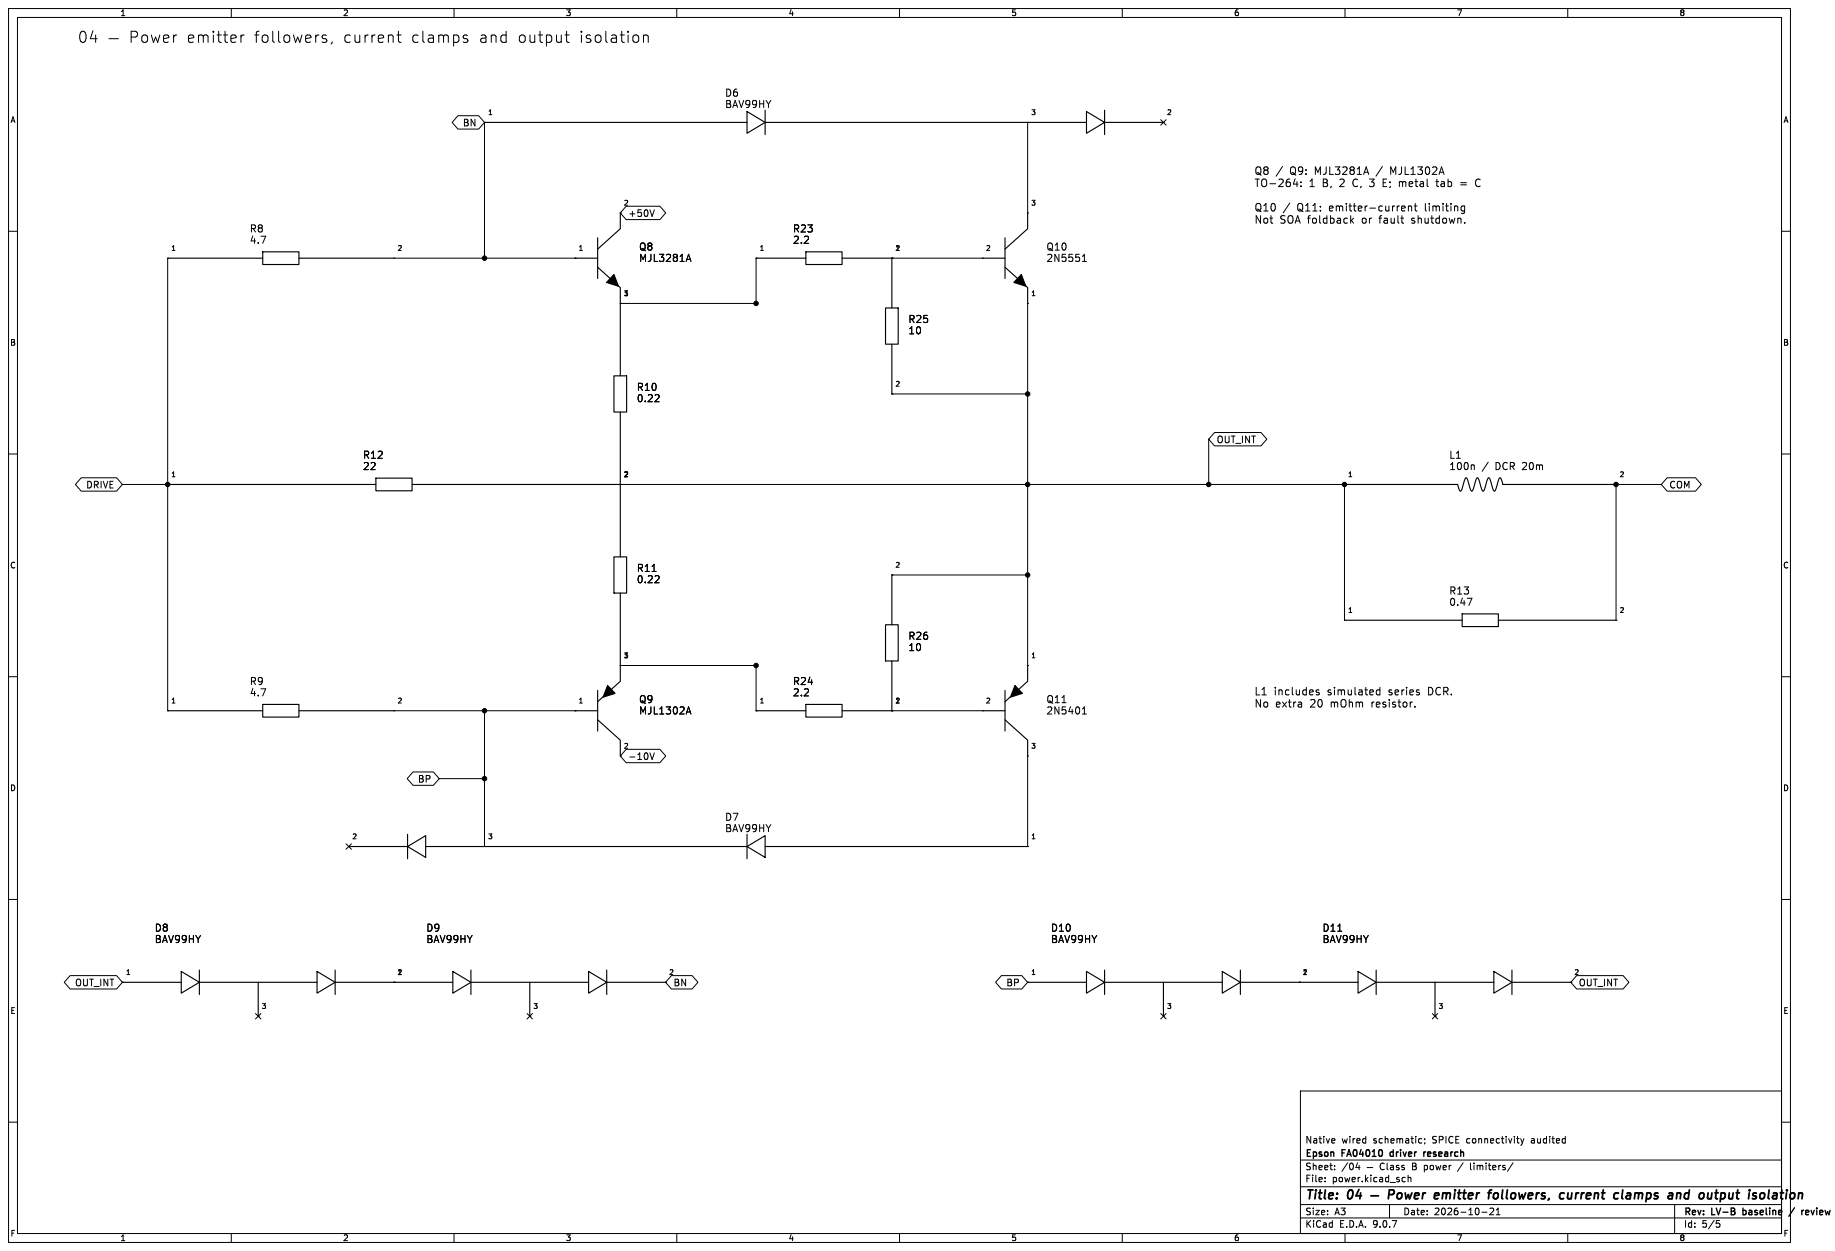
[picture p11: page 5]

No extra 20 mOhm resistor.
