ttoomat/work-2026-itmo/DNA/class_B/LTspice/Draft2.asc

B1: bi2; I=(V(B)+10)/({R3})
B2: bi2; I=(50-V(D)-0.81)/({R2})
B3: bi2; I=((V(v_in)-V(B)-1)/{R1})
B4: bi2; I=({betta1}+1)*((V(v_in)-V(B)-1)/{R1})*{R3}-10
D1: diode
D2: diode
Q1: npn; 2N2222
Q2: pnp; 2N5401
R7: res; {R1}
R11: res; 1Meg
R12: res; {R4}
R13: res; {R2}
R14: res; {R3}
V1: voltage; -10
V2: voltage; 8
V3: voltage; 2.5
V4: voltage; PWL file=signal_pwl.txt
V6: voltage; 50
V7: voltage; -10
V8: voltage; SINE(1 1 1k)
Named nets: 0, oa_neg, oa_pos, ref, V_IN, D, b1, B
.tran 3m
.param R1 10k
.param R2 1.2
.param R3 1
.param R4 20k
.param betta1 200
Ib1 - gut
Ie2 - gut
Ie1 - gut
VB
