ttoomat/work-2026-itmo/DNA/class_B/LTspice/Draft1.asc

AC1: voltage; AC 1 0
U3: UniversalOpAmp5
V2: voltage; -10
V3: voltage; 50
Named nets: 0, in, neg, pos, out
.tran 3m
.ac dec 20 10 100Meg
