ttoomat/work-2026-itmo/DNA/class_B/LTspice/Draft3.asc

C1: cap; 10µ
C2: cap; 1m
Q1: npn
R1: res; 1k
R2: res; 0.5k
R3: res; 9k
R4: res; 10k
R5: res; 10k
V1: voltage; SINE(0 0.5 1k)
V2: voltage; 30
Named nets: 0, out, in
.tran 3m
