ttoomat/work-2026-itmo/DNA/class_D/transient/COM_1nf.cir

* Manual user run: complete power/controller loop; engineering linear input stage.
* Prototype development - controller and selectable power-stage models; not PCB release
.param FSW=6Meg TPER=1/FSW LPH=500n CFIX=468n CNOM=480n
.param KP=4 KD=0.25u KI=10000000 TF=25n TDIF=5n
.param TDELAY=13.5n TDEAD=5n
Vground sysgnd 0 10
Vbus bus 0 60
Vref ref 0 PWL(0u 10 2u 10 7u 21.3 10u 21.3 13u 21.3 14u 7.2 18.2u 7.2 21u 21.3 24u 21.3 26.5u 28.2 27.7u 28.2 30.2u 21.3 32u 21.3 35u 51.8 38.5u 51.8 41.5u 7.2 44.5u 7.2 45.5u 21.3 49u 21.3)
Vinput input sysgnd PWL(0u 0.231252118838 2u 0.231252118838 7u 0.829934359191 10u 0.829934359191 13u 0.829934359191 14u 0.0829060769801 18.2u 0.0829060769801 21u 0.829934359191 24u 0.829934359191 26.5u 1.19550139091 27.7u 1.19550139091 30.2u 0.829934359191 32u 0.829934359191 35u 2.44584660085 38.5u 2.44584660085 41.5u 0.0829060769801 44.5u 0.0829060769801 45.5u 0.829934359191 49u 0.829934359191)
.include "../models/compatible/OPA859.lib"
Vlogic logic 0 5
Vmid mid 0 1.65
* OPA2192 linear input model: 10 MHz GBP, 2 channels, RC input.
* Actual resistor circuit and original TI macro-model: frontend_check.py.
Vaux aux15 sysgnd 5
Ifront aux15 0 2m
Rinput input fi 100
Cinput fi sysgnd 47p
Ebuffer eb 0 fi 0 1
Rbuffer eb b 1k
Cbuffer b 0 15.9154943p
Blevel lev 0 V=0.626653733867*V(b)-0.59332*V(sysgnd)-0.0808117679107*V(mid)
Rlevel lev lv 1k
Clevel lv 0 2.6644634625e-11
Enorm rnorm 0 lv 0 1

Rplus rnorm plus 249
Cref_filter plus mid 1.6n
Rbias mid plus 2.94k
Rfb error minus 2.94k
RmeasureA out minus 15k
RmeasureB out minus 15k
RgainA minus gainmid 255
RgainB gainmid 0 2.55
Xerror plus minus logic 0 error pd OA859_OPA859
Vpd pd 0 PWL(0 0 .8u 0 .801u 5)
Rlead error lead 2.94k
Clead error lead 124.7p
Rleadr lead mid 215
Eservo_monitor servo 0 mid 0 1
Ccmp lead mid 2p
* Integral target: KI=3e6 V/V/s in original high-voltage behavioral model.
* 30000/s integral of error amplifier deviation; behavioral and clamped.
.include "../models/vendor/opa810_sbomb73a/opa810_a.lib"
Vclock clock 0 PWL(0u 2.5 0.00025u 0 0.031u 0 0.0315u 5 0.0935u 5 0.094u 0 0.156u 0 0.1565u 5 0.2185u 5 0.219u 0 0.281u 0 0.2815u 5 0.3435u 5 0.344u 0 0.406u 0 0.4065u 5 0.4685u 5 0.469u 0 0.531u 0 0.5315u 5 0.5935u 5 0.594u 0 0.656u 0 0.6565u 5 0.7185u 5 0.719u 0 0.781u 0 0.7815u 5 0.8435u 5 0.844u 0 0.906u 0 0.9065u 5 0.9685u 5 0.969u 0 1.031u 0 1.0315u 5 1.0935u 5 1.094u 0 1.156u 0 1.1565u 5 1.2185u 5 1.219u 0 1.281u 0 1.2815u 5 1.3435u 5 1.344u 0 1.406u 0 1.4065u 5 1.4685u 5 1.469u 0 1.531u 0 1.5315u 5 1.5935u 5 1.594u 0 1.656u 0 1.6565u 5 1.7185u 5 1.719u 0 1.781u 0 1.7815u 5 1.8435u 5 1.844u 0 1.906u 0 1.9065u 5 1.9685u 5 1.969u 0 2.031u 0 2.0315u 5 2.0935u 5 2.094u 0 2.156u 0 2.1565u 5 2.2185u 5 2.219u 0 2.281u 0 2.2815u 5 2.3435u 5 2.344u 0 2.406u 0 2.4065u 5 2.4685u 5 2.469u 0 2.531u 0 2.5315u 5 2.5935u 5 2.594u 0 2.656u 0 2.6565u 5 2.7185u 5 2.719u 0 2.781u 0 2.7815u 5 2.8435u 5 2.844u 0 2.906u 0 2.9065u 5 2.9685u 5 2.969u 0 3.031u 0 3.0315u 5 3.0935u 5 3.094u 0 3.156u 0 3.1565u 5 3.2185u 5 3.219u 0 3.281u 0 3.2815u 5 3.3435u 5 3.344u 0 3.406u 0 3.4065u 5 3.4685u 5 3.469u 0 3.531u 0 3.5315u 5 3.5935u 5 3.594u 0 3.656u 0 3.6565u 5 3.7185u 5 3.719u 0 3.781u 0 3.7815u 5 3.8435u 5 3.844u 0 3.906u 0 3.9065u 5 3.9685u 5 3.969u 0 4.031u 0 4.0315u 5 4.0935u 5 4.094u 0 4.156u 0 4.1565u 5 4.2185u 5 4.219u 0 4.281u 0 4.2815u 5 4.3435u 5 4.344u 0 4.406u 0 4.4065u 5 4.4685u 5 4.469u 0 4.531u 0 4.5315u 5 4.5935u 5 4.594u 0 4.656u 0 4.6565u 5 4.7185u 5 4.719u 0 4.781u 0 4.7815u 5 4.8435u 5 4.844u 0 4.906u 0 4.9065u 5 4.9685u 5 4.969u 0 5.031u 0 5.0315u 5 5.0935u 5 5.094u 0 5.156u 0 5.1565u 5 5.2185u 5 5.219u 0 5.281u 0 5.2815u 5 5.3435u 5 5.344u 0 5.406u 0 5.4065u 5 5.4685u 5 5.469u 0 5.531u 0 5.5315u 5 5.5935u 5 5.594u 0 5.656u 0 5.6565u 5 5.7185u 5 5.719u 0 5.781u 0 5.7815u 5 5.8435u 5 5.844u 0 5.906u 0 5.9065u 5 5.9685u 5 5.969u 0 6.031u 0 6.0315u 5 6.0935u 5 6.094u 0 6.156u 0 6.1565u 5 6.2185u 5 6.219u 0 6.281u 0 6.2815u 5 6.3435u 5 6.344u 0 6.406u 0 6.4065u 5 6.4685u 5 6.469u 0 6.531u 0 6.5315u 5 6.5935u 5 6.594u 0 6.656u 0 6.6565u 5 6.7185u 5 6.719u 0 6.781u 0 6.7815u 5 6.8435u 5 6.844u 0 6.906u 0 6.9065u 5 6.9685u 5 6.969u 0 7.031u 0 7.0315u 5 7.0935u 5 7.094u 0 7.156u 0 7.1565u 5 7.2185u 5 7.219u 0 7.281u 0 7.2815u 5 7.3435u 5 7.344u 0 7.406u 0 7.4065u 5 7.4685u 5 7.469u 0 7.531u 0 7.5315u 5 7.5935u 5 7.594u 0 7.656u 0 7.6565u 5 7.7185u 5 7.719u 0 7.781u 0 7.7815u 5 7.8435u 5 7.844u 0 7.906u 0 7.9065u 5 7.9685u 5 7.969u 0 8.031u 0 8.0315u 5 8.0935u 5 8.094u 0 8.156u 0 8.1565u 5 8.2185u 5 8.219u 0 8.281u 0 8.2815u 5 8.3435u 5 8.344u 0 8.406u 0 8.4065u 5 8.4685u 5 8.469u 0 8.531u 0 8.5315u 5 8.5935u 5 8.594u 0 8.656u 0 8.6565u 5 8.7185u 5 8.719u 0 8.781u 0 8.7815u 5 8.8435u 5 8.844u 0 8.906u 0 8.9065u 5 8.9685u 5 8.969u 0 9.031u 0 9.0315u 5 9.0935u 5 9.094u 0 9.156u 0 9.1565u 5 9.2185u 5 9.219u 0 9.281u 0 9.2815u 5 9.3435u 5 9.344u 0 9.406u 0 9.4065u 5 9.4685u 5 9.469u 0 9.531u 0 9.5315u 5 9.5935u 5 9.594u 0 9.656u 0 9.6565u 5 9.7185u 5 9.719u 0 9.781u 0 9.7815u 5 9.8435u 5 9.844u 0 9.906u 0 9.9065u 5 9.9685u 5 9.969u 0 10.031u 0 10.0315u 5 10.0935u 5 10.094u 0 10.156u 0 10.1565u 5 10.2185u 5 10.219u 0 10.281u 0 10.2815u 5 10.3435u 5 10.344u 0 10.406u 0 10.4065u 5 10.4685u 5 10.469u 0 10.531u 0 10.5315u 5 10.5935u 5 10.594u 0 10.656u 0 10.6565u 5 10.7185u 5 10.719u 0 10.781u 0 10.7815u 5 10.8435u 5 10.844u 0 10.906u 0 10.9065u 5 10.9685u 5 10.969u 0 11.031u 0 11.0315u 5 11.0935u 5 11.094u 0 11.156u 0 11.1565u 5 11.2185u 5 11.219u 0 11.281u 0 11.2815u 5 11.3435u 5 11.344u 0 11.406u 0 11.4065u 5 11.4685u 5 11.469u 0 11.531u 0 11.5315u 5 11.5935u 5 11.594u 0 11.656u 0 11.6565u 5 11.7185u 5 11.719u 0 11.781u 0 11.7815u 5 11.8435u 5 11.844u 0 11.906u 0 11.9065u 5 11.9685u 5 11.969u 0 12.031u 0 12.0315u 5 12.0935u 5 12.094u 0 12.156u 0 12.1565u 5 12.2185u 5 12.219u 0 12.281u 0 12.2815u 5 12.3435u 5 12.344u 0 12.406u 0 12.4065u 5 12.4685u 5 12.469u 0 12.531u 0 12.5315u 5 12.5935u 5 12.594u 0 12.656u 0 12.6565u 5 12.7185u 5 12.719u 0 12.781u 0 12.7815u 5 12.8435u 5 12.844u 0 12.906u 0 12.9065u 5 12.9685u 5 12.969u 0 13.031u 0 13.0315u 5 13.0935u 5 13.094u 0 13.156u 0 13.1565u 5 13.2185u 5 13.219u 0 13.281u 0 13.2815u 5 13.3435u 5 13.344u 0 13.406u 0 13.4065u 5 13.4685u 5 13.469u 0 13.531u 0 13.5315u 5 13.5935u 5 13.594u 0 13.656u 0 13.6565u 5 13.7185u 5 13.719u 0 13.781u 0 13.7815u 5 13.8435u 5 13.844u 0 13.906u 0 13.9065u 5 13.9685u 5 13.969u 0 14.031u 0 14.0315u 5 14.0935u 5 14.094u 0 14.156u 0 14.1565u 5 14.2185u 5 14.21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
185u 5 81.219u 0 81.281u 0 81.2815u 5 81.3435u 5 81.344u 0 81.406u 0 81.4065u 5 81.4685u 5 81.469u 0 81.531u 0 81.5315u 5 81.5935u 5 81.594u 0 81.656u 0 81.6565u 5 81.7185u 5 81.719u 0 81.781u 0 81.7815u 5 81.8435u 5 81.844u 0 81.906u 0 81.9065u 5 81.9685u 5 81.969u 0 82.031u 0 82.0315u 5 82.0935u 5 82.094u 0 82.156u 0 82.1565u 5 82.2185u 5 82.219u 0 82.281u 0 82.2815u 5 82.3435u 5 82.344u 0 82.406u 0 82.4065u 5 82.4685u 5 82.469u 0 82.531u 0 82.5315u 5 82.5935u 5 82.594u 0 82.656u 0 82.6565u 5 82.7185u 5 82.719u 0 82.781u 0 82.7815u 5 82.8435u 5 82.844u 0 82.906u 0 82.9065u 5 82.9685u 5 82.969u 0 83.031u 0 83.0315u 5 83.0935u 5 83.094u 0 83.156u 0 83.1565u 5 83.2185u 5 83.219u 0 83.281u 0 83.2815u 5 83.3435u 5 83.344u 0 83.406u 0 83.4065u 5 83.4685u 5 83.469u 0 83.531u 0 83.5315u 5 83.5935u 5 83.594u 0 83.656u 0 83.6565u 5 83.7185u 5 83.719u 0 83.781u 0 83.7815u 5 83.8435u 5 83.844u 0 83.906u 0 83.9065u 5 83.9685u 5 83.969u 0 84.031u 0 84.0315u 5 84.0935u 5 84.094u 0
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
