ttoomat/work-2026-itmo/DNA/class_B/class_B_manual/class_B_manual.kicad_sch

## KiCad design DNA/class_B/class_B_manual/class_B_manual.kicad_sch (2026-10-31)

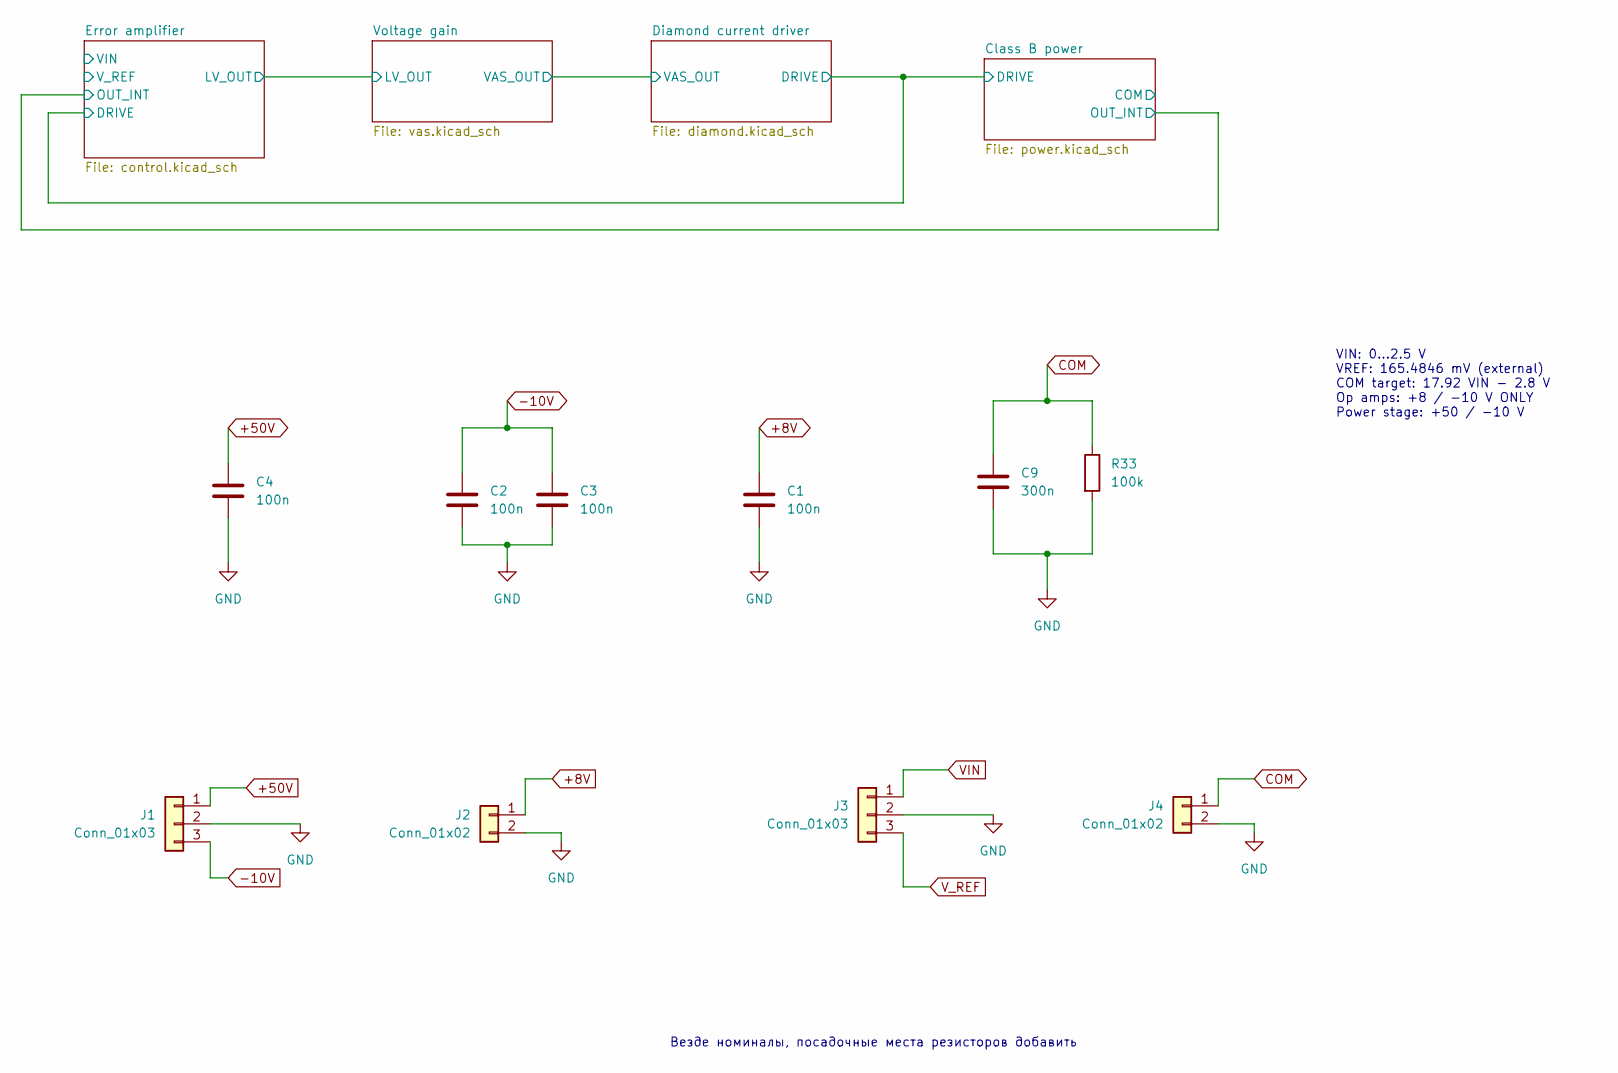
[picture p12: schematic class_B_manual.kicad_sch]

Parts:
C1, C2, C3, C4: 100n
C9: 300n
J1, J3: Conn_01x03
J2, J4: Conn_01x02
R33: 100k

Connections:
+8V: C1.1, J2.1
+50V: C4.1, J1.1
-10V: C2.1, C3.1, J1.3
COM: C9.1, J4.1, R33.1
GND: C1.2, C2.2, C3.2, C4.2, C9.2, J1.2, J2.2, J3.2, J4.2, R33.2
VIN: J3.1
V_REF: J3.3

Notes on the sheet:
VIN: 0...2.5 V VREF: 165.4846 mV (external) COM target: 17.92 VIN - 2.8 V Op amps: +8 / -10 V ONLY Power stage: +50 / -10 V
Везде номиналы, посадочные места резисторов добавить
