ttoomat/work-2026-itmo/DNA/class_B/class_B_manual/control.kicad_sch

## KiCad design DNA/class_B/class_B_manual/control.kicad_sch (2026-11-06)

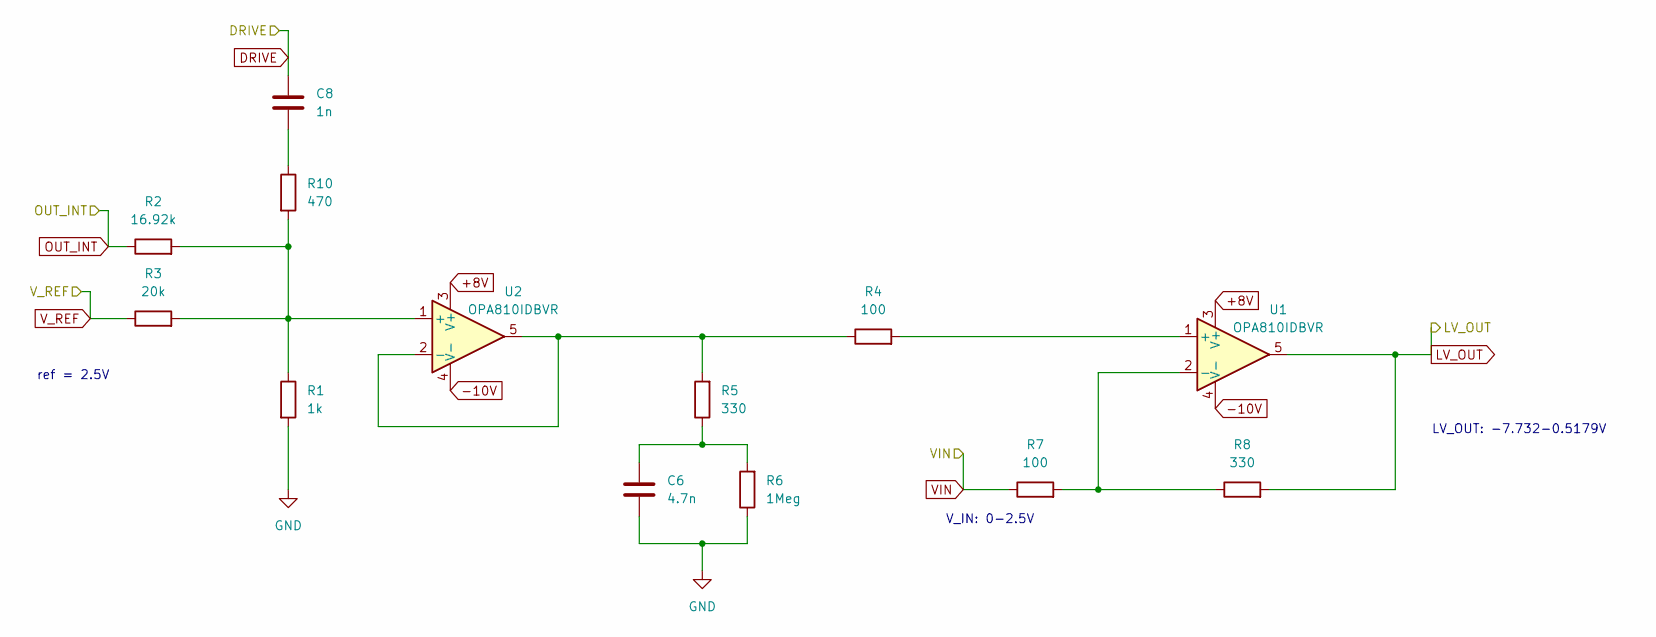
[picture p13: schematic control.kicad_sch]

Parts:
C6: 4.7n
C8: 1n
R1: 1k
R2: 16.92k
R3: 20k
R4, R7: 100
R5, R8: 330
R6: 1Meg
R10: 470
U1, U2: OPA810IDBVR; SOT-23-5_HandSoldering

Connections:
+8V: U1.3 (V+), U2.3 (V+)
-10V: U1.4 (V-), U2.4 (V-)
DRIVE: C8.1
GND: C6.2, R1.2, R6.1
LV_OUT: R8.2, U1.5
unnamed: C6.1, R5.1, R6.2
unnamed: C8.2, R10.1
unnamed: R1.1, R2.2, R3.2, R10.2, U2.1 (+)
unnamed: R4.1, R5.2, U2.2 (-), U2.5
unnamed: R4.2, U1.1 (+)
unnamed: R7.2, R8.1, U1.2 (-)
OUT_INT: R2.1
VIN: R7.1
V_REF: R3.1

Notes on the sheet:
ref = 2.5V
LV_OUT: -7.732-0.5179V
V_IN: 0-2.5V
