ttoomat/work-2026-itmo/DNA/class_B/class_B_manual/diamond.kicad_sch

## KiCad design DNA/class_B/class_B_manual/diamond.kicad_sch (2026-10-31)

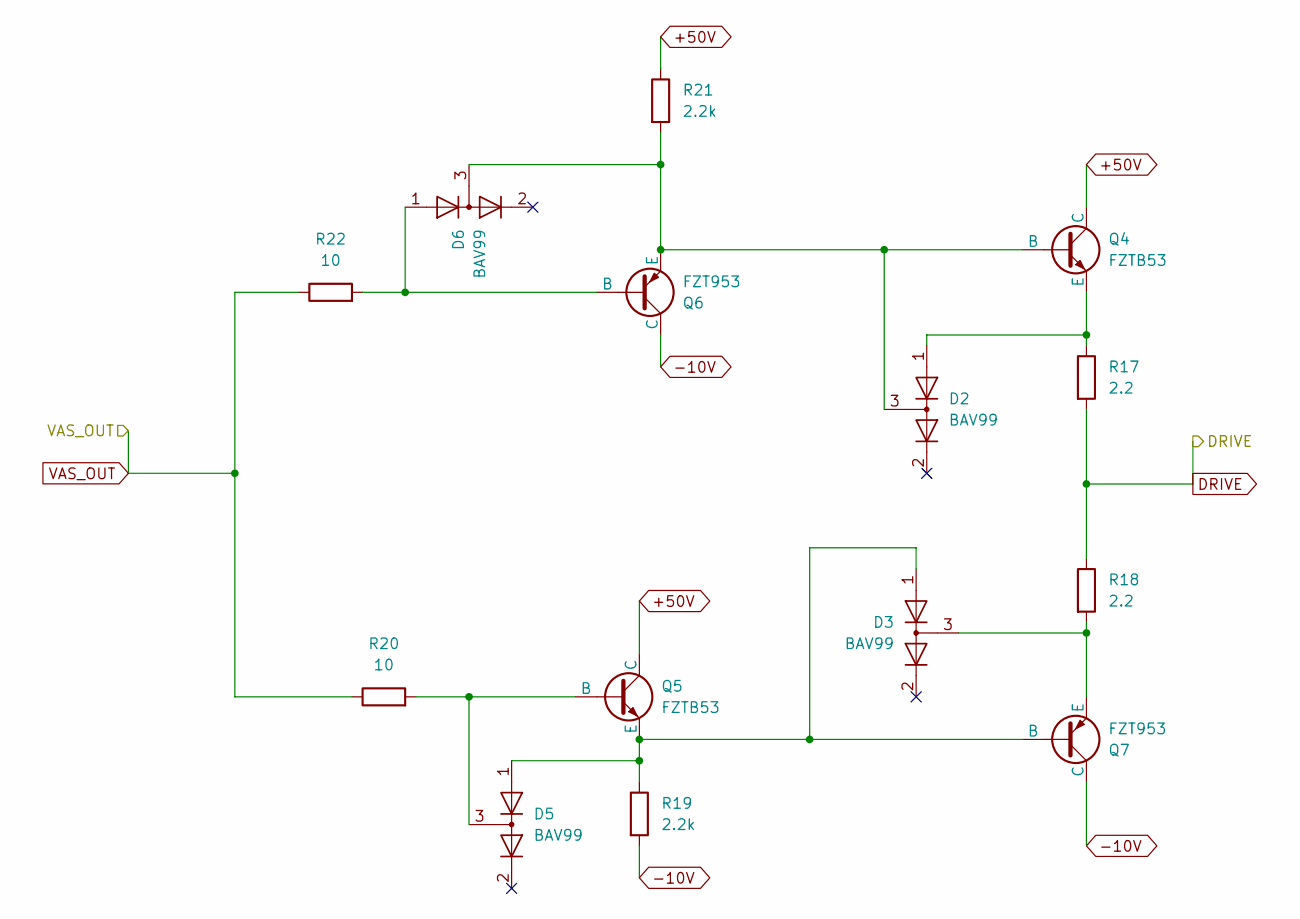
[picture p14: schematic diamond.kicad_sch]

Parts:
D2, D3, D5, D6: BAV99; SOT-23
Q4, Q5: FZTB53; SOT-223-3_TabPin2
Q6, Q7: FZT953; SOT-223-3_TabPin2
R17, R18: 2.2
R19, R21: 2.2k
R20, R22: 10

Connections:
+50V: Q4.2 (C), Q5.2 (C), R21.1
-10V: Q6.2 (C), Q7.2 (C), R19.2
DRIVE: R17.2, R18.1
unnamed: D2.1 (K), Q4.3 (E), R17.1
unnamed: D2.3 (K), D6.3 (K), Q4.1 (B), Q6.3 (E), R21.2
unnamed: D3.1 (K), D5.1 (K), Q5.3 (E), Q7.1 (B), R19.1
unnamed: D3.3 (K), Q7.3 (E), R18.2
unnamed: D5.3 (K), Q5.1 (B), R20.2
unnamed: D6.1 (K), Q6.1 (B), R22.2
VAS_OUT: R20.1, R22.1
