ttoomat/work-2026-itmo/DNA/class_B/class_B_manual/power.kicad_sch

## KiCad design DNA/class_B/class_B_manual/power.kicad_sch (2026-10-31)

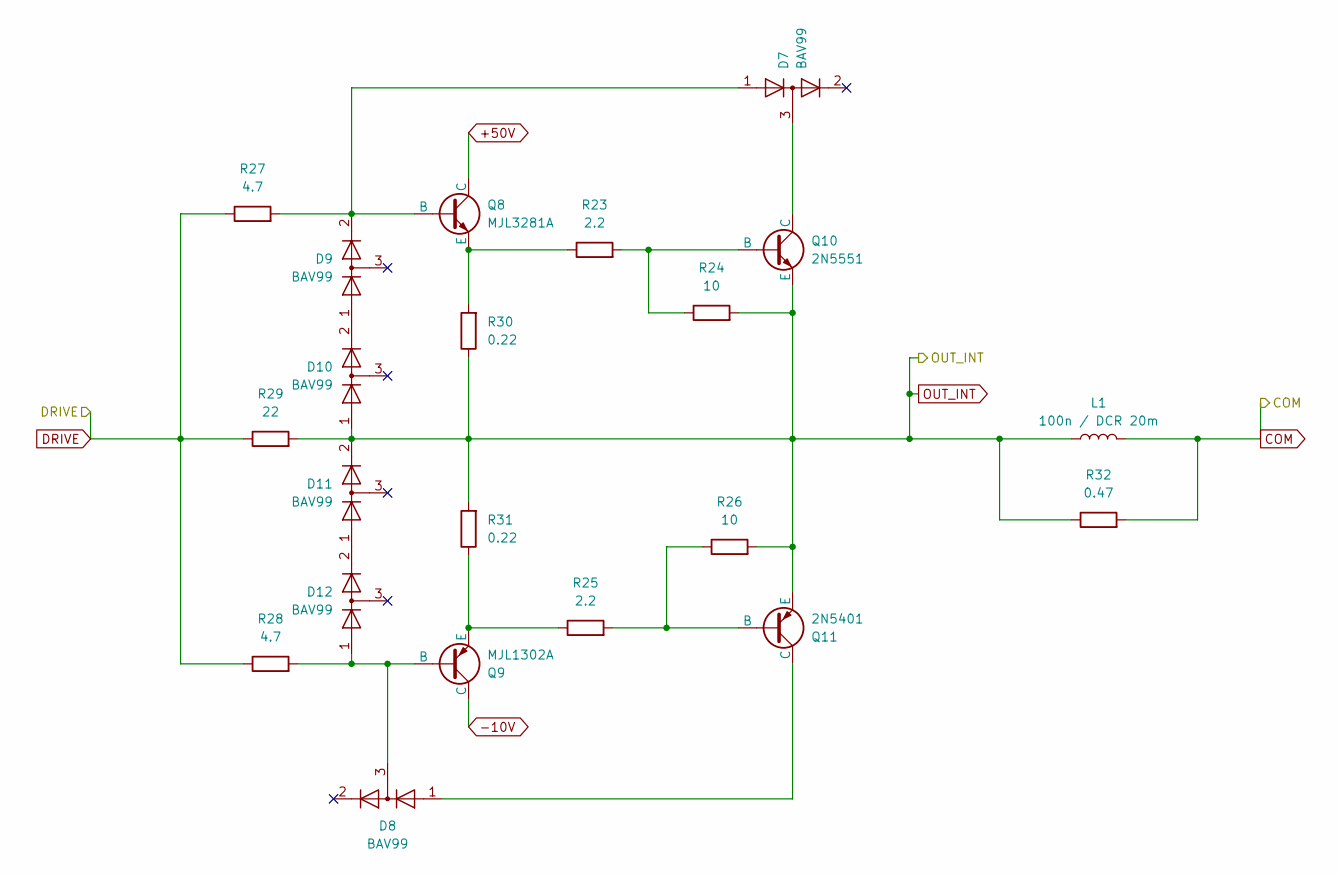
[picture p15: schematic power.kicad_sch]

Parts:
D7, D8, D9, D10, D11, D12: BAV99; SOT-23
L1: 100n / DCR 20m
Q8: MJL3281A; TO-264-3_Vertical
Q9: MJL1302A; TO-264-3_Vertical
Q10: 2N5551; TO-92_Inline
Q11: 2N5401; TO-92_Inline
R23, R25: 2.2
R24, R26: 10
R27, R28: 4.7
R29: 22
R30, R31: 0.22
R32: 0.47

Connections:
+50V: Q8.2 (C)
-10V: Q9.2 (C)
COM: L1.2, R32.2
DRIVE: R27.1, R28.1, R29.1
unnamed: D7.1 (K), D9.2 (A), Q8.1 (B), R27.2
unnamed: D7.3 (K), Q10.2 (C)
unnamed: D8.1 (K), Q11.2 (C)
unnamed: D9.1 (K), D10.2 (A)
unnamed: D11.1 (K), D12.2 (A)
unnamed: D8.3 (K), D12.1 (K), Q9.1 (B), R28.2
unnamed: Q8.3 (E), R23.1, R30.2
unnamed: Q9.3 (E), R25.1, R31.1
unnamed: Q10.1 (B), R23.2, R24.1
unnamed: Q11.1 (B), R25.2, R26.1
OUT_INT: D10.1 (K), D11.2 (A), L1.1, Q10.3 (E), Q11.3 (E), R24.2, R26.2, R29.2, R30.1, R31.2, R32.1
