ttoomat/work-2026-itmo/DNA/class_B/class_B_manual/vas.kicad_sch

## KiCad design DNA/class_B/class_B_manual/vas.kicad_sch (2026-10-31)

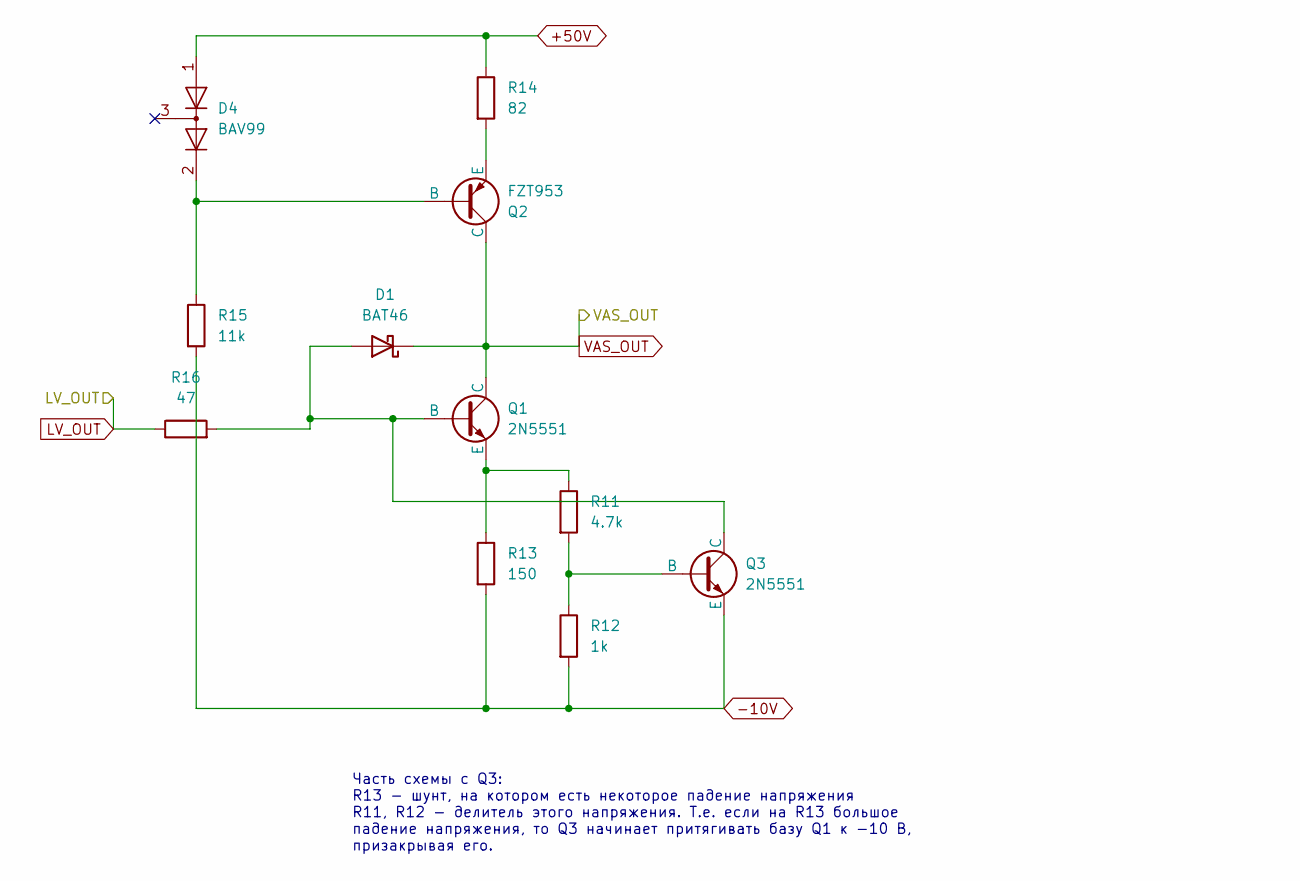
[picture p16: schematic vas.kicad_sch]

Parts:
D1: BAT46; D_DO-35_SOD27_P7.62mm_Horizontal
D4: BAV99; SOT-23
Q1, Q3: 2N5551; TO-92_Inline
Q2: FZT953; SOT-223-3_TabPin2
R11: 4.7k
R12: 1k
R13: 150
R14: 82
R15: 11k
R16: 47

Connections:
+50V: D4.1 (K), R14.1
-10V: Q3.1 (E), R12.2, R13.2, R15.2
LV_OUT: R16.1
unnamed: D1.2 (A), Q1.2 (B), Q3.3 (C), R16.2
unnamed: D4.2 (A), Q2.1 (B), R15.1
unnamed: Q1.1 (E), R11.1, R13.1
unnamed: Q2.3 (E), R14.2
unnamed: Q3.2 (B), R11.2, R12.1
VAS_OUT: D1.1 (K), Q1.3 (C), Q2.2 (C)

Notes on the sheet:
Часть схемы с Q3: R13 - шунт, на котором есть некоторое падение напряжения R11, R12 - делитель этого напряжения. Т.е. если на R13 большое падение напряжения, то Q3 начинает притягивать базу Q1 к -10 В, призакрывая его.
