ttoomat/work-2026-itmo/DNA/class_D/class_D_manual/Power.kicad_sch

## KiCad design DNA/class_D/class_D_manual/Power.kicad_sch (2026-10-30)

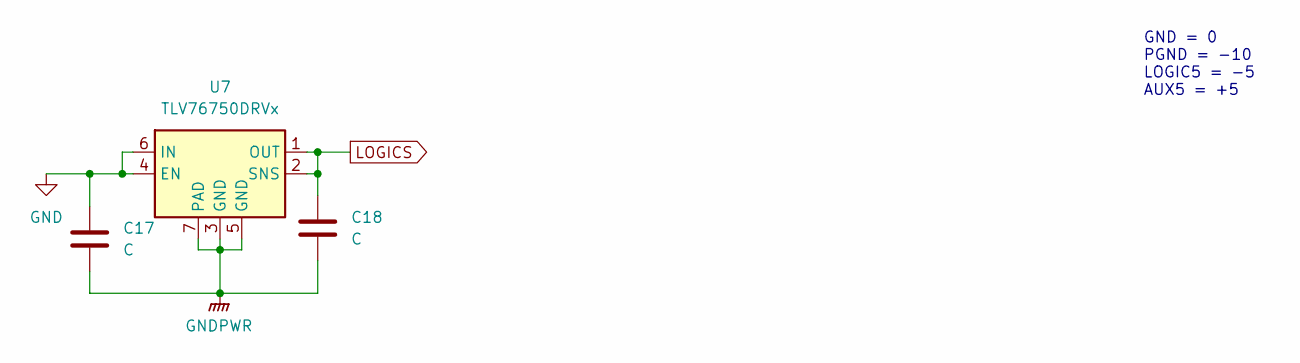
[picture p17: schematic Power.kicad_sch]

Parts:
C17, C18: C
U7: TLV76750DRVx; WSON-6-1EP_2x2mm_P0.65mm_EP1x1.6mm_ThermalVias

Connections:
GND: C17.1, U7.4 (EN), U7.6 (IN)
GNDPWR: C17.2, C18.2, U7.3 (GND), U7.5 (GND), U7.7 (PAD)
LOGICS: C18.1, U7.1 (OUT), U7.2 (SNS)

Notes on the sheet:
GND = 0 PGND = -10 LOGIC5 = -5 AUX5 = +5
