ttoomat/work-2026-itmo/DNA/class_D/class_D_manual/analog_input.kicad_sch

## KiCad design DNA/class_D/class_D_manual/analog_input.kicad_sch (2026-10-30)

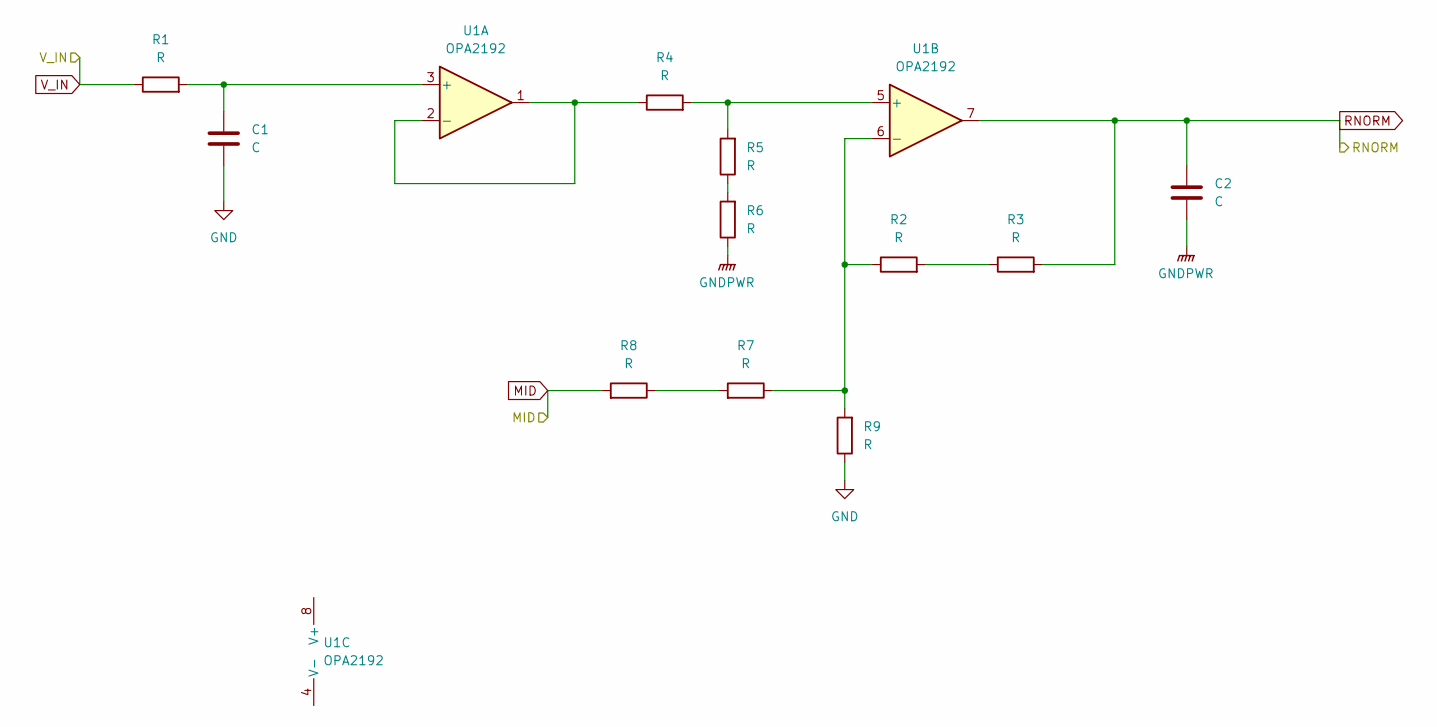
[picture p18: schematic analog_input.kicad_sch]

Parts:
C1, C2: C
R1, R2, R3, R4, R5, R6, R7, R8, R9: R
U1: OPA2192; SOIC-8_3.9x4.9mm_P1.27mm

Connections:
GND: C1.2, R9.1
GNDPWR: C2.2, R6.1
MID: R8.2
unnamed: C1.1, R1.2, U1.3 (+)
unnamed: R2.1, R7.1, R9.2, U1.6 (-)
unnamed: R2.2, R3.1
unnamed: R4.1, U1.1, U1.2 (-)
unnamed: R4.2, R5.2, U1.5 (+)
unnamed: R5.1, R6.2
unnamed: R7.2, R8.1
RNORM: C2.1, R3.2, U1.7
V_IN: R1.1
