ttoomat/work-2026-itmo/DNA/class_D/class_D_manual/fb_and_comp.kicad_sch

## KiCad design DNA/class_D/class_D_manual/fb_and_comp.kicad_sch (2026-10-30)

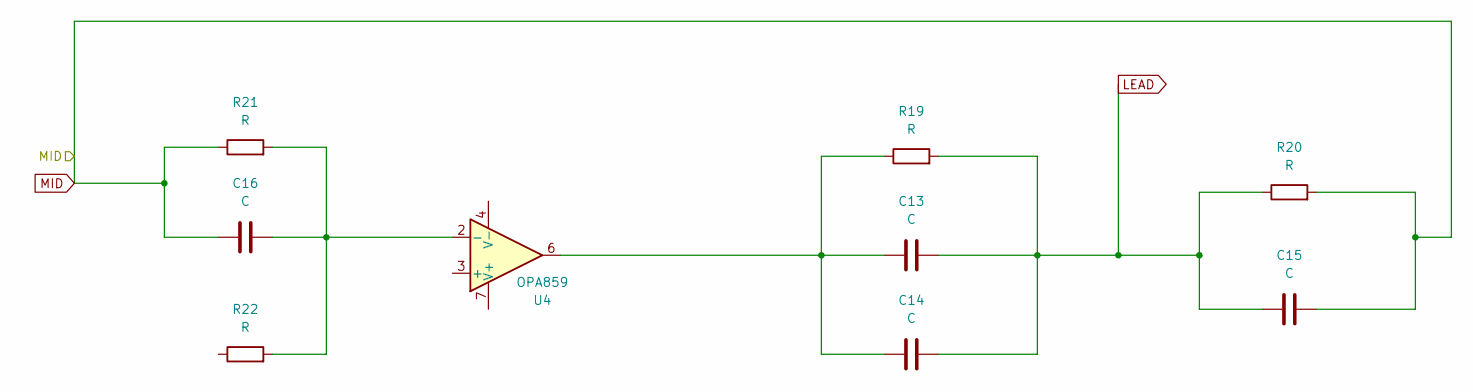
[picture p19: schematic fb_and_comp.kicad_sch]

Parts:
C13, C14, C15, C16: C
R19, R20, R21, R22: R
U4: OPA859

Connections:
LEAD: C13.2, C14.2, C15.1, R19.2, R20.1
MID: C15.2, C16.1, R20.2, R21.1
unnamed: C13.1, C14.1, R19.1, U4.6
unnamed: C16.2, R21.2, R22.2, U4.2 (-)
