ttoomat/work-2026-itmo/DNA/class_D/class_D_manual/fpga_interface.kicad_sch

## KiCad design DNA/class_D/class_D_manual/fpga_interface.kicad_sch (2026-10-30)

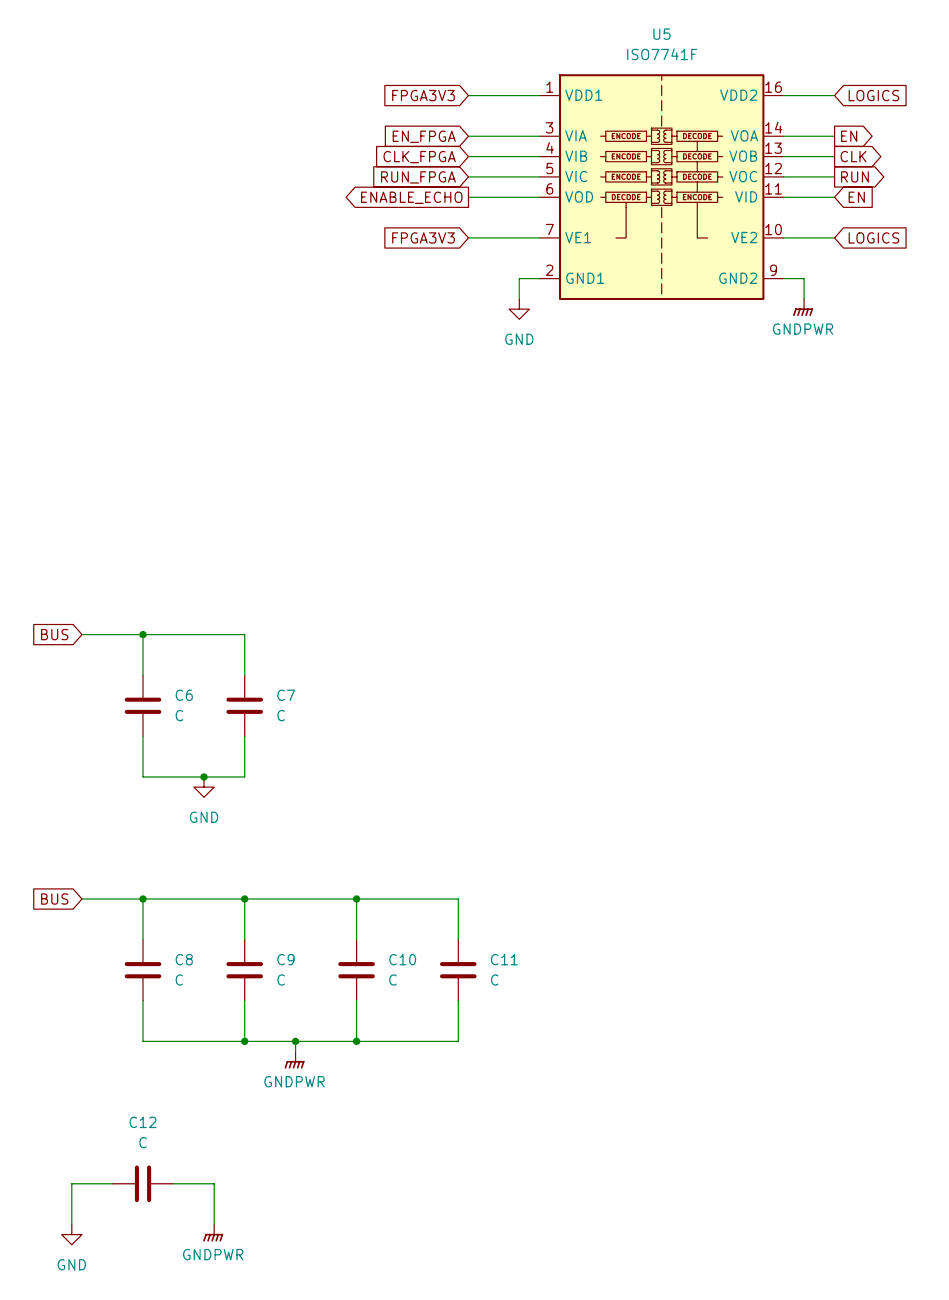
[picture p20: schematic fpga_interface.kicad_sch]

Parts:
C6, C7, C8, C9, C10, C11, C12: C
U5: ISO7741F; SOIC-16W_7.5x10.3mm_P1.27mm

Connections:
BUS: C6.1, C7.1, C8.1, C9.1, C10.1, C11.1
CLK: U5.13 (VOB)
CLK_FPGA: U5.4 (VIB)
EN: U5.11 (VID), U5.14 (VOA)
ENABLE_ECHO: U5.6 (VOD)
EN_FPGA: U5.3 (VIA)
FPGA3V3: U5.1 (VDD1), U5.7 (VE1)
GND: C6.2, C7.2, C12.1, U5.2 (GND1), U5.8 (GND1)
GNDPWR: C8.2, C9.2, C10.2, C11.2, C12.2, U5.9 (GND2), U5.15 (GND2)
LOGICS: U5.10 (VE2), U5.16 (VDD2)
RUN: U5.12 (VOC)
RUN_FPGA: U5.5 (VIC)
