ttoomat/work-2026-itmo/DNA/class_D/class_D_manual/pwm_gen.kicad_sch

## KiCad design DNA/class_D/class_D_manual/pwm_gen.kicad_sch (2026-10-30)

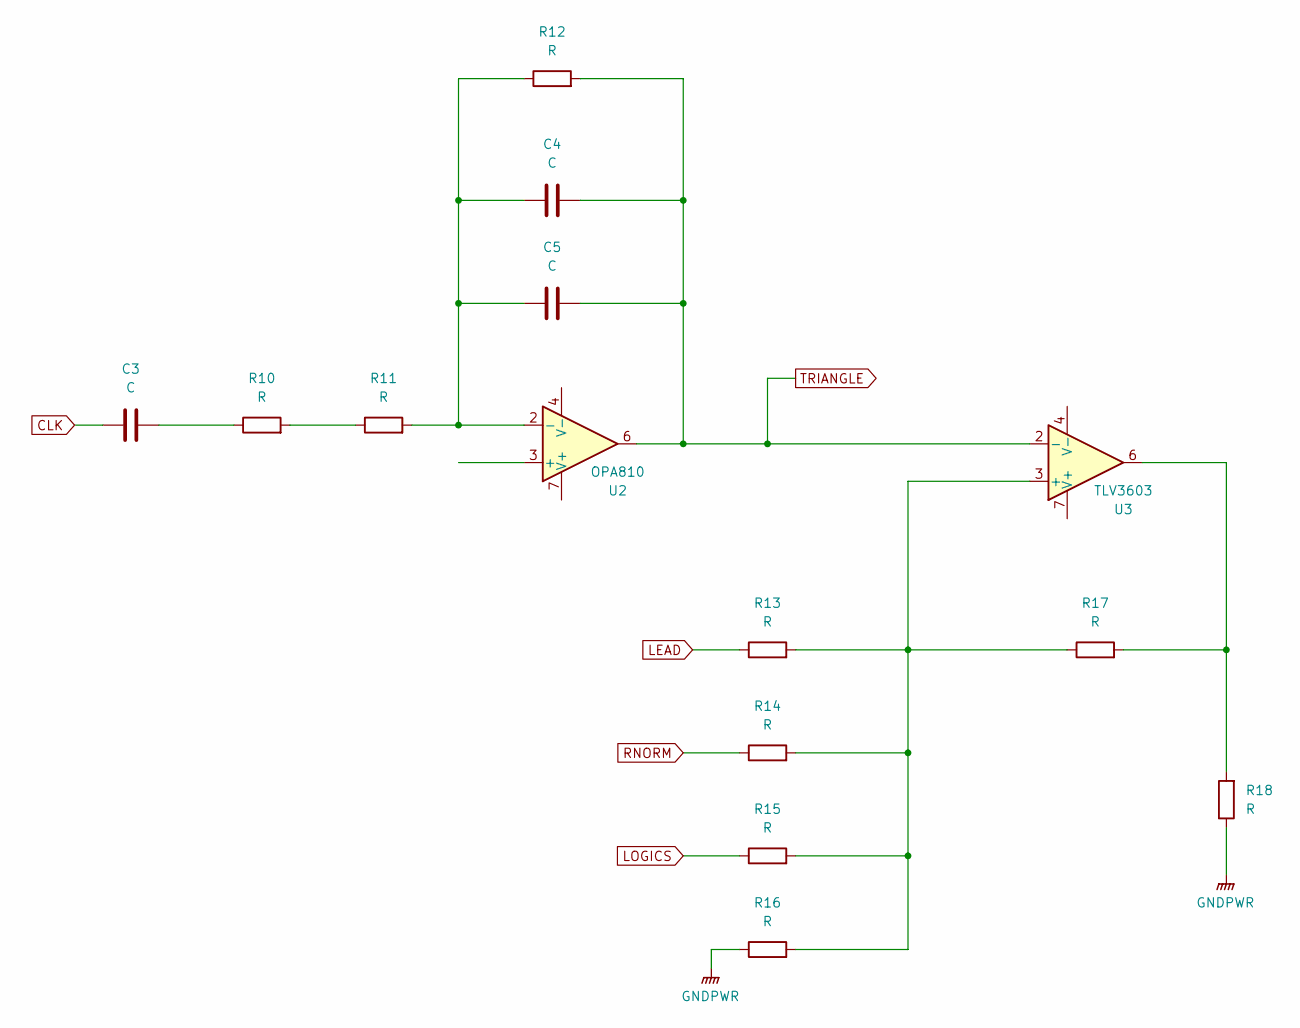
[picture p21: schematic pwm_gen.kicad_sch]

Parts:
C3, C4, C5: C
R10, R11, R12, R13, R14, R15, R16, R17, R18: R
U2: OPA810
U3: TLV3603

Connections:
CLK: C3.1
GNDPWR: R16.1, R18.1
LEAD: R13.1
LOGICS: R15.1
unnamed: C3.2, R10.1
unnamed: C4.1, C5.1, R11.2, R12.1, U2.2 (-)
unnamed: R10.2, R11.1
unnamed: R13.2, R14.2, R15.2, R16.2, R17.1, U3.3 (+)
unnamed: R17.2, R18.2, U3.6
RNORM: R14.1
TRIANGLE: C4.2, C5.2, R12.2, U2.6, U3.2 (-)
