ttoomat/work-2026-itmo/DNA/class_B/AI/kicad/class_b_lv.kicad_sch

## KiCad design DNA/class_B/AI/kicad/class_b_lv.kicad_sch (2026-10-29)

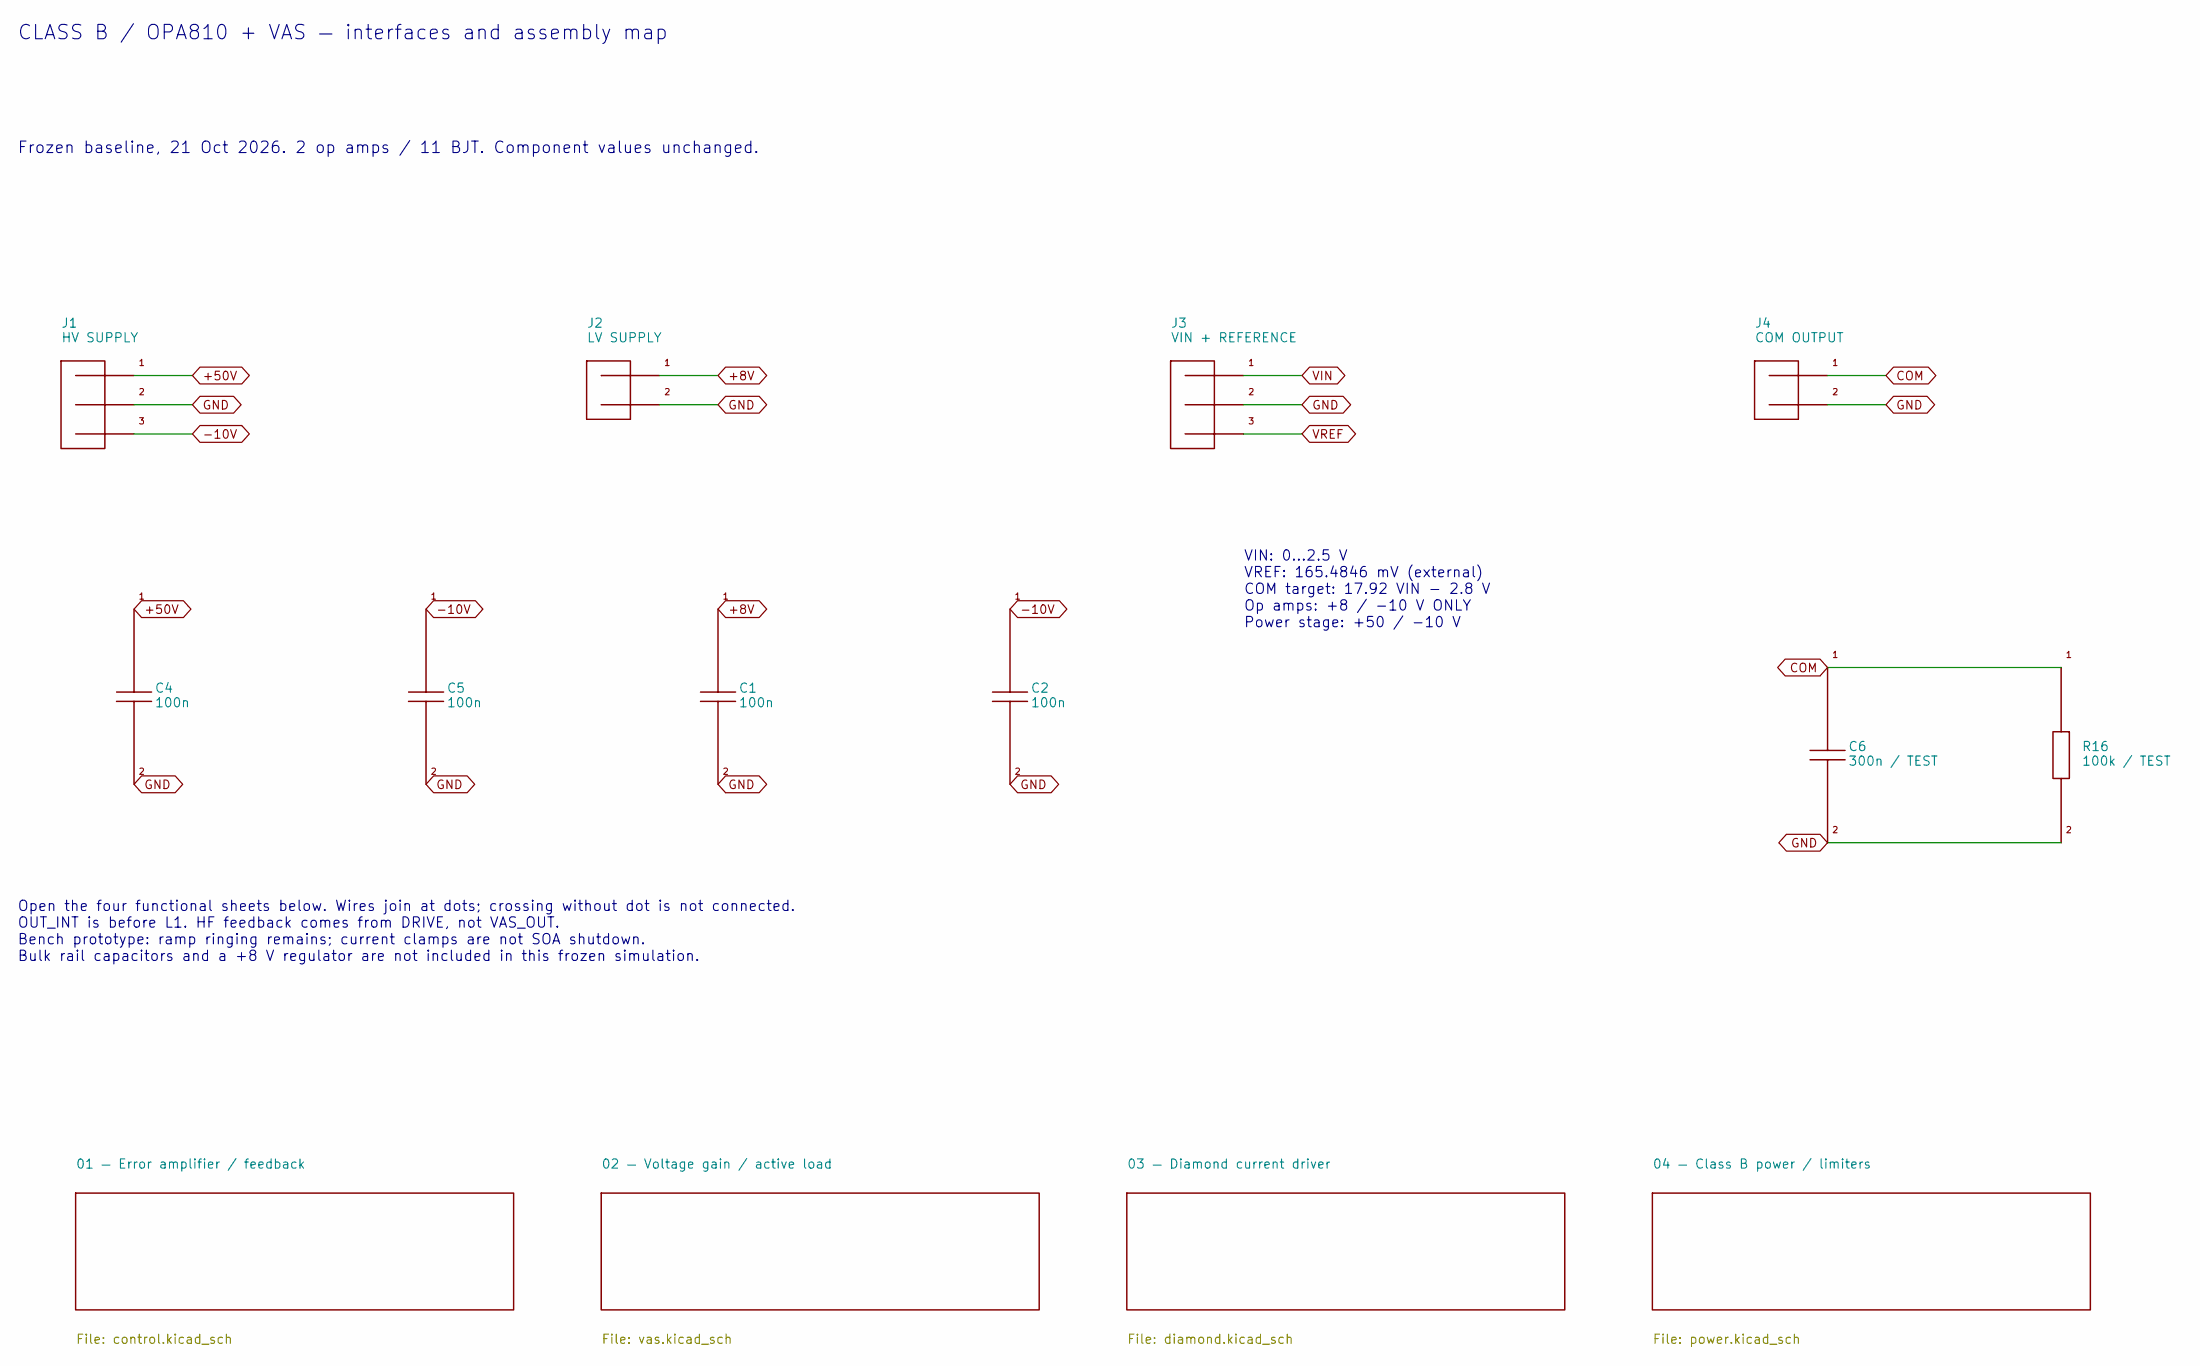
[picture p22: schematic class_b_lv.kicad_sch]

Parts:
C1, C2, C4, C5: 100n
C6: 300n / TEST
J1: HV SUPPLY
J2: LV SUPPLY
J3: VIN + REFERENCE
J4: COM OUTPUT
R16: 100k / TEST

Connections:
+8V: C1.1, J2.1
+50V: C4.1, J1.1
-10V: C2.1, C5.1, J1.3
COM: C6.1, J4.1, R16.1
GND: C1.2, C2.2, C4.2, C5.2, C6.2, J1.2, J2.2, J3.2, J4.2, R16.2
VIN: J3.1
VREF: J3.3

Notes on the sheet:
CLASS B / OPA810 + VAS — interfaces and assembly map
Frozen baseline, 21 Oct 2026. 2 op amps / 11 BJT. Component values unchanged.
VIN: 0...2.5 V VREF: 165.4846 mV (external) COM target: 17.92 VIN - 2.8 V Op amps: +8 / -10 V ONLY Power stage: +50 / -10 V
Open the four functional sheets below. Wires join at dots; crossing without dot is not connected. OUT_INT is before L1. HF feedback comes from DRIVE, not VAS_OUT. Bench prototype: ramp ringing remains; current clamps are not SOA shutdown. Bulk rail capacitors and a +8 V regulator are not included i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
