ttoomat/work-2026-itmo/DNA/class_B/AI/kicad/control.kicad_sch

## KiCad design DNA/class_B/AI/kicad/control.kicad_sch (2026-10-29)

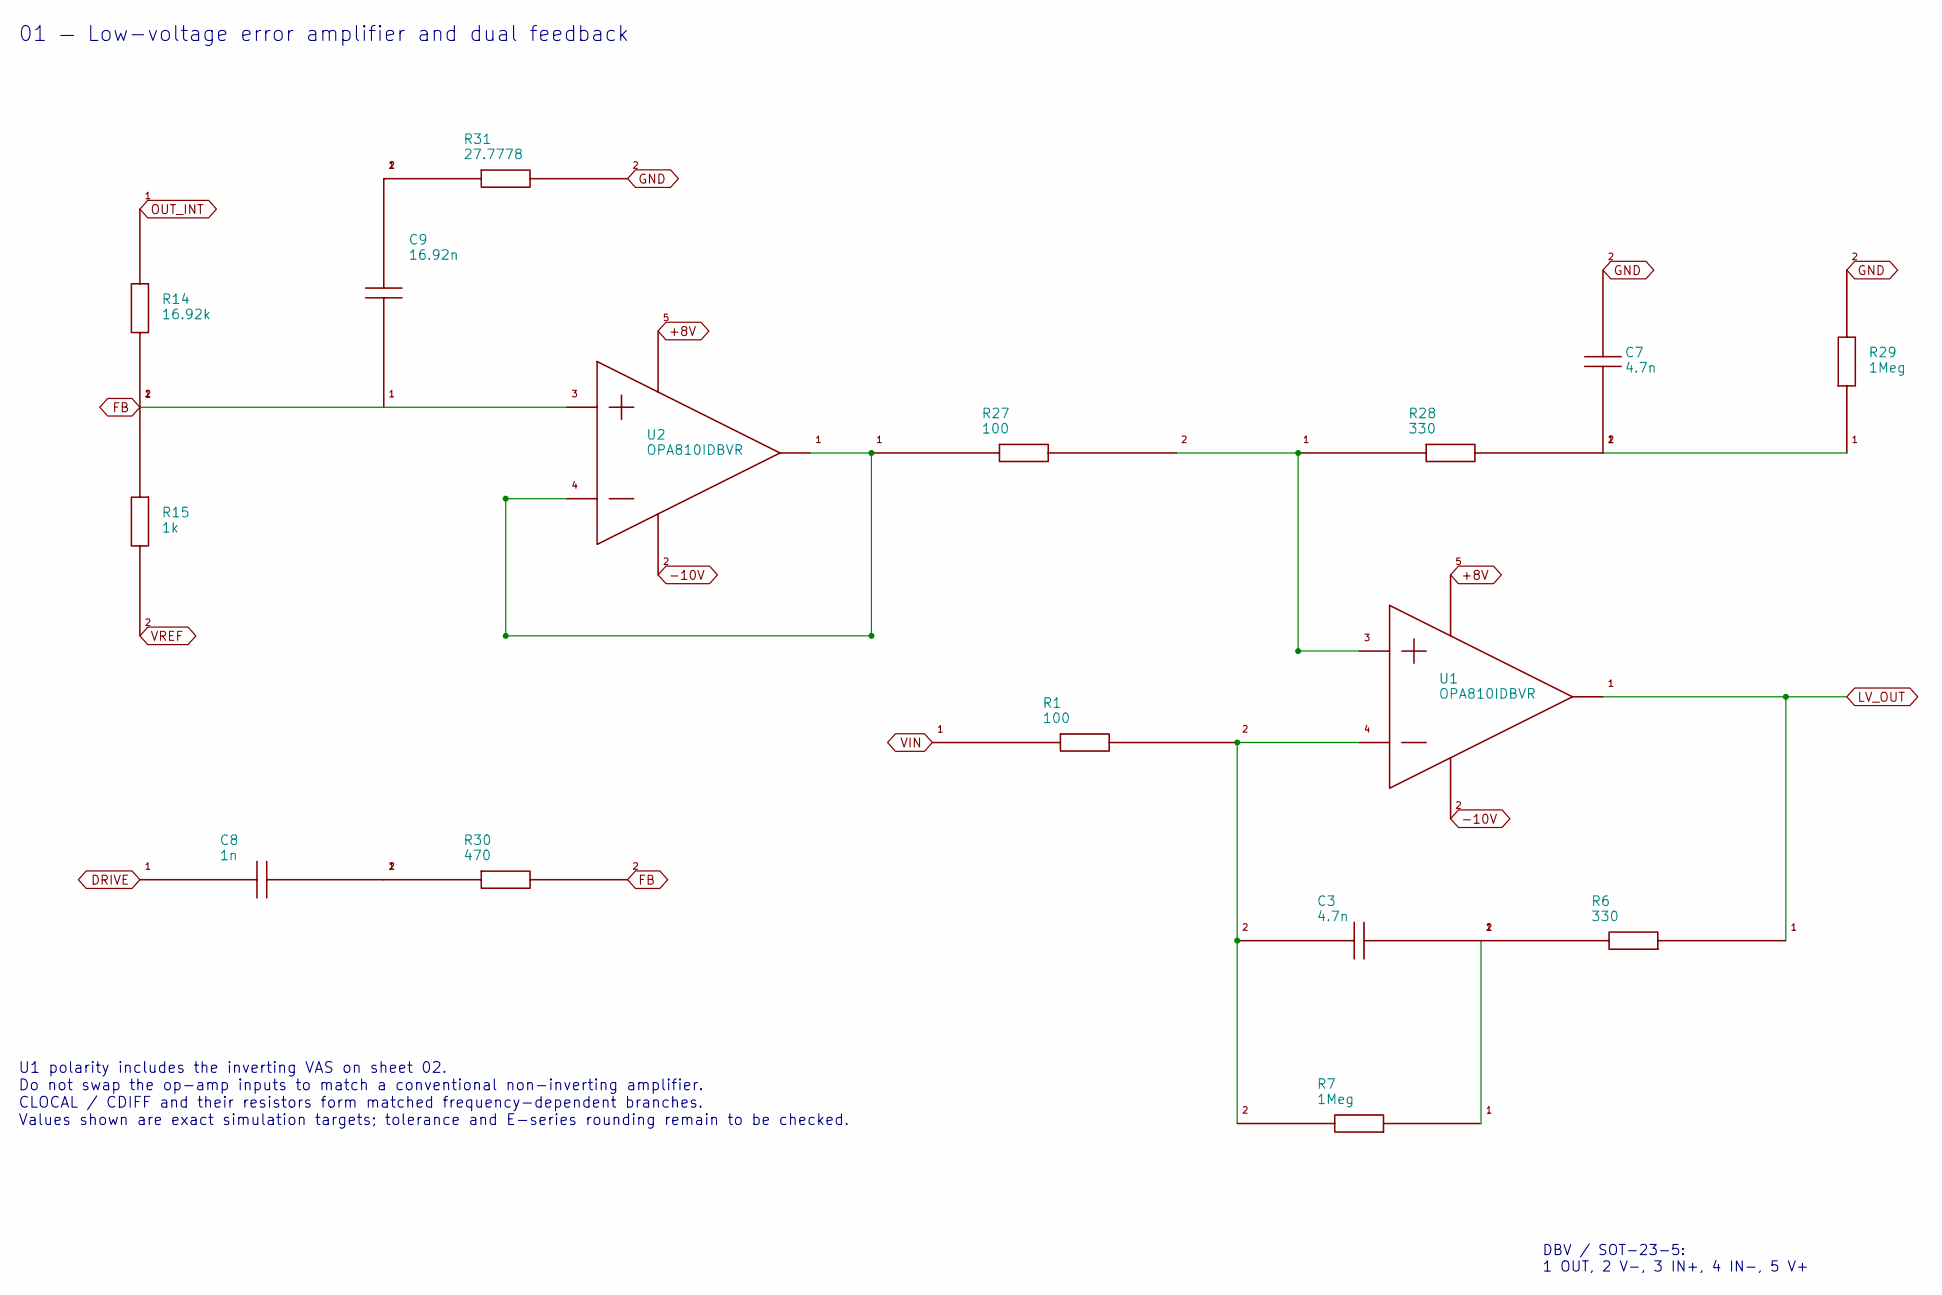
[picture p23: schematic control.kicad_sch]

Parts:
C3, C7: 4.7n
C8: 1n
C9: 16.92n
R1, R27: 100
R6, R28: 330
R7, R29: 1Meg
R14: 16.92k
R15: 1k
R30: 470
R31: 27.7778
U1, U2: OPA810IDBVR; SOT-23-5

Connections:
+8V: U1.5, U2.5
-10V: U1.2, U2.2
DRIVE: C8.1
FB: C9.1, R14.2, R15.1, R30.2, U2.3
GND: C7.2, R29.2, R31.2
LV_OUT: R6.1, U1.1
unnamed: C3.1, R6.2, R7.1
unnamed: C3.2, R1.2, R7.2, U1.4
unnamed: C7.1, R28.2, R29.1
unnamed: C8.2, R30.1
unnamed: C9.2, R31.1
unnamed: R27.1, U2.1, U2.4
unnamed: R27.2, R28.1, U1.3
OUT_INT: R14.1
VIN: R1.1
VREF: R15.2

Notes on the sheet:
01 — Low-voltage error amplifier and dual feedback
U1 polarity includes the inverting VAS on sheet 02. Do not swap the op-amp inputs to match a conventional non-inverting amplifier. CLOCAL / CDIFF and their resistors form matched frequency-dependent branches. Values shown are exact simulation targets; tolerance and E-series rounding remain to be ch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
DBV / SOT-23-5: 1 OUT, 2 V-, 3 IN+, 4 IN-, 5 V+
