ttoomat/work-2026-itmo/DNA/class_B/AI/kicad/diamond.kicad_sch

## KiCad design DNA/class_B/AI/kicad/diamond.kicad_sch (2026-10-29)

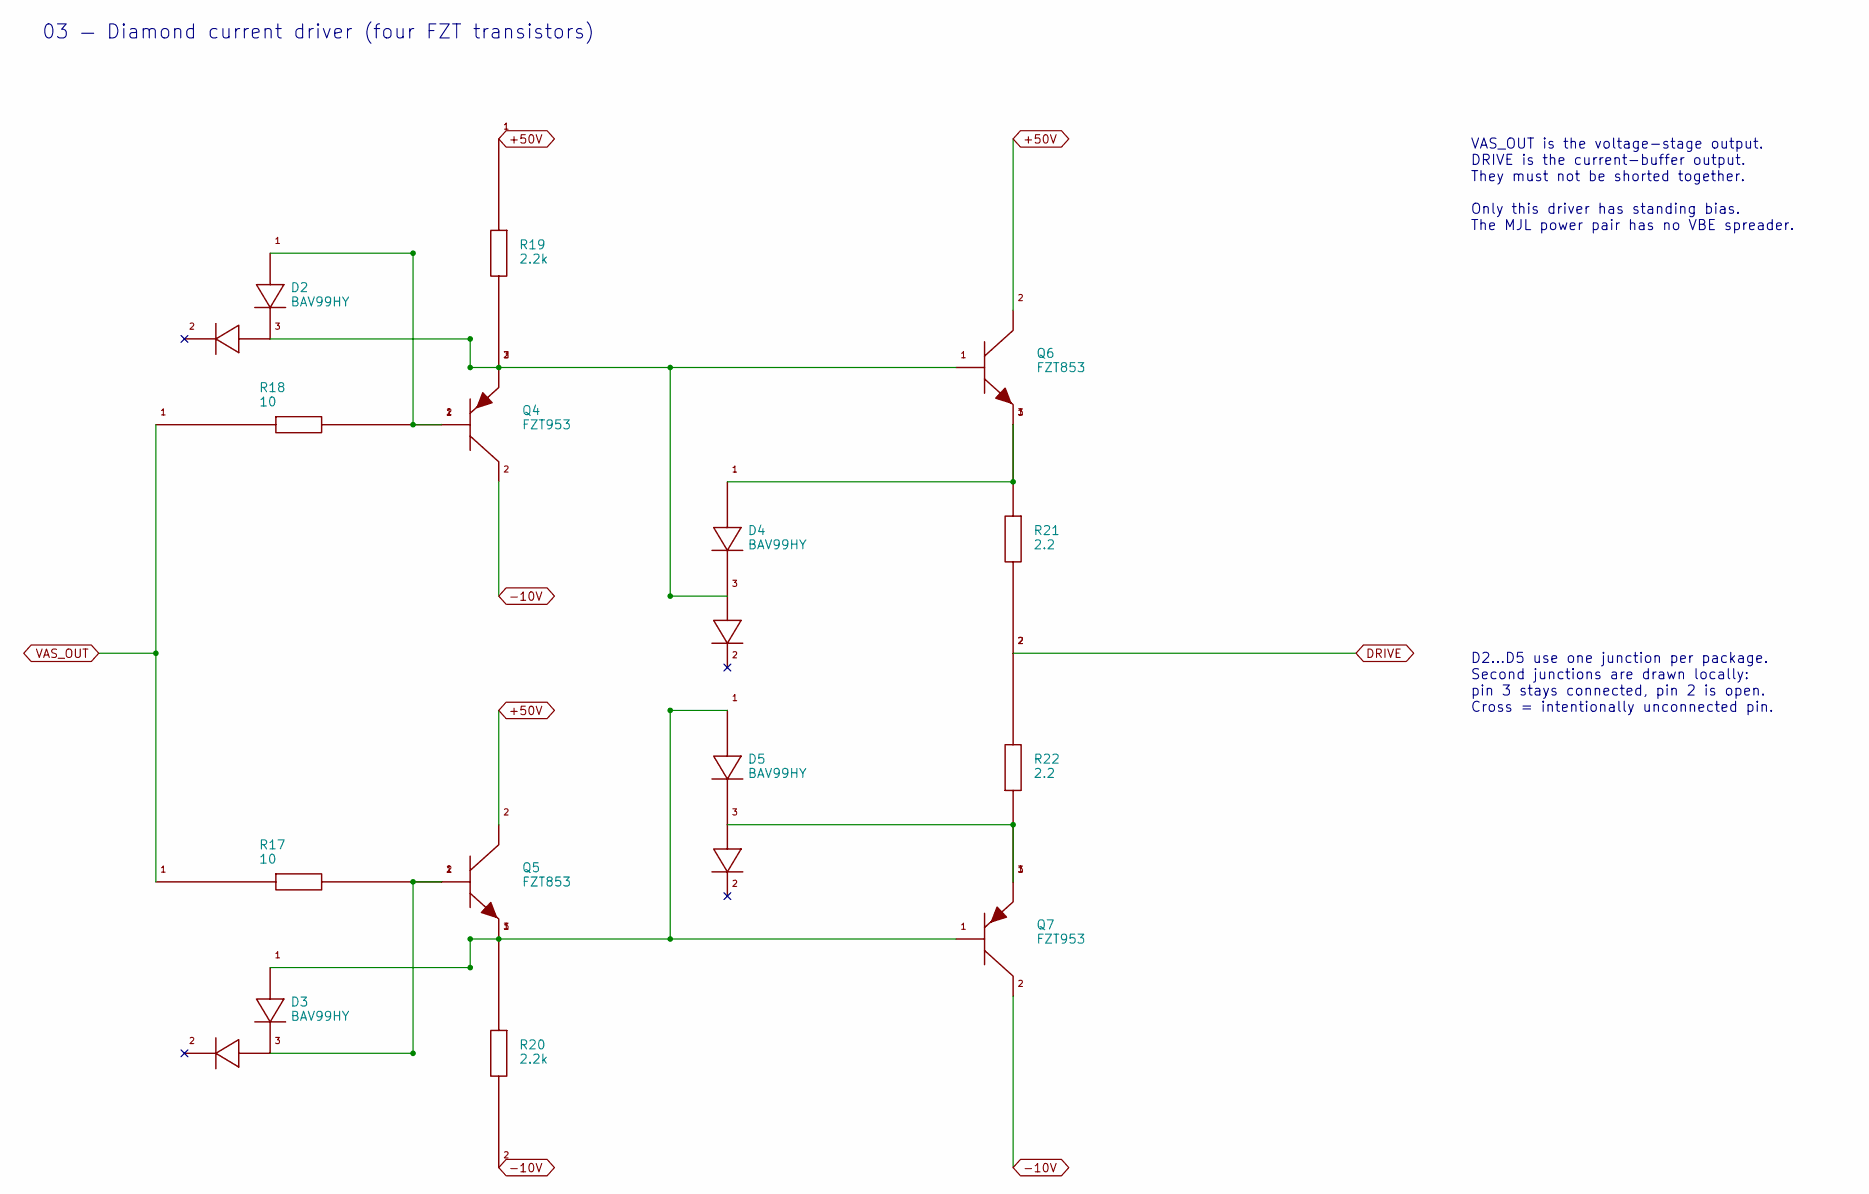
[picture p24: schematic diamond.kicad_sch]

Parts:
D2, D3, D4, D5: BAV99HY; SOT-23
Q4, Q7: FZT953; SOT-223-3_TabPin2
Q5, Q6: FZT853; SOT-223-3_TabPin2
R17, R18: 10
R19, R20: 2.2k
R21, R22: 2.2

Connections:
+50V: Q5.2 (C), Q6.2 (C), R19.1
-10V: Q4.2 (C), Q7.2 (C), R20.2
DRIVE: R21.2, R22.2
unnamed: D2.1, Q4.1 (B), R18.2
unnamed: D2.3, D4.3, Q4.3 (E), Q6.1 (B), R19.2
unnamed: D3.1, D5.1, Q5.3 (E), Q7.1 (B), R20.1
unnamed: D3.3, Q5.1 (B), R17.2
unnamed: D4.1, Q6.3 (E), R21.1
unnamed: D5.3, Q7.3 (E), R22.1
VAS_OUT: R17.1, R18.1

Notes on the sheet:
03 — Diamond current driver (four FZT transistors)
VAS_OUT is the voltage-stage output. DRIVE is the current-buffer output. They must not be shorted together. Only this driver has standing bias. The MJL power pair has no VBE spreader.
D2...D5 use one junction per package. Second junctions are drawn locally: pin 3 stays connected, pin 2 is open. Cross = intentionally unconnected pin.
