ttoomat/work-2026-itmo/DNA/class_B/AI/kicad/power.kicad_sch

## KiCad design DNA/class_B/AI/kicad/power.kicad_sch (2026-10-29)

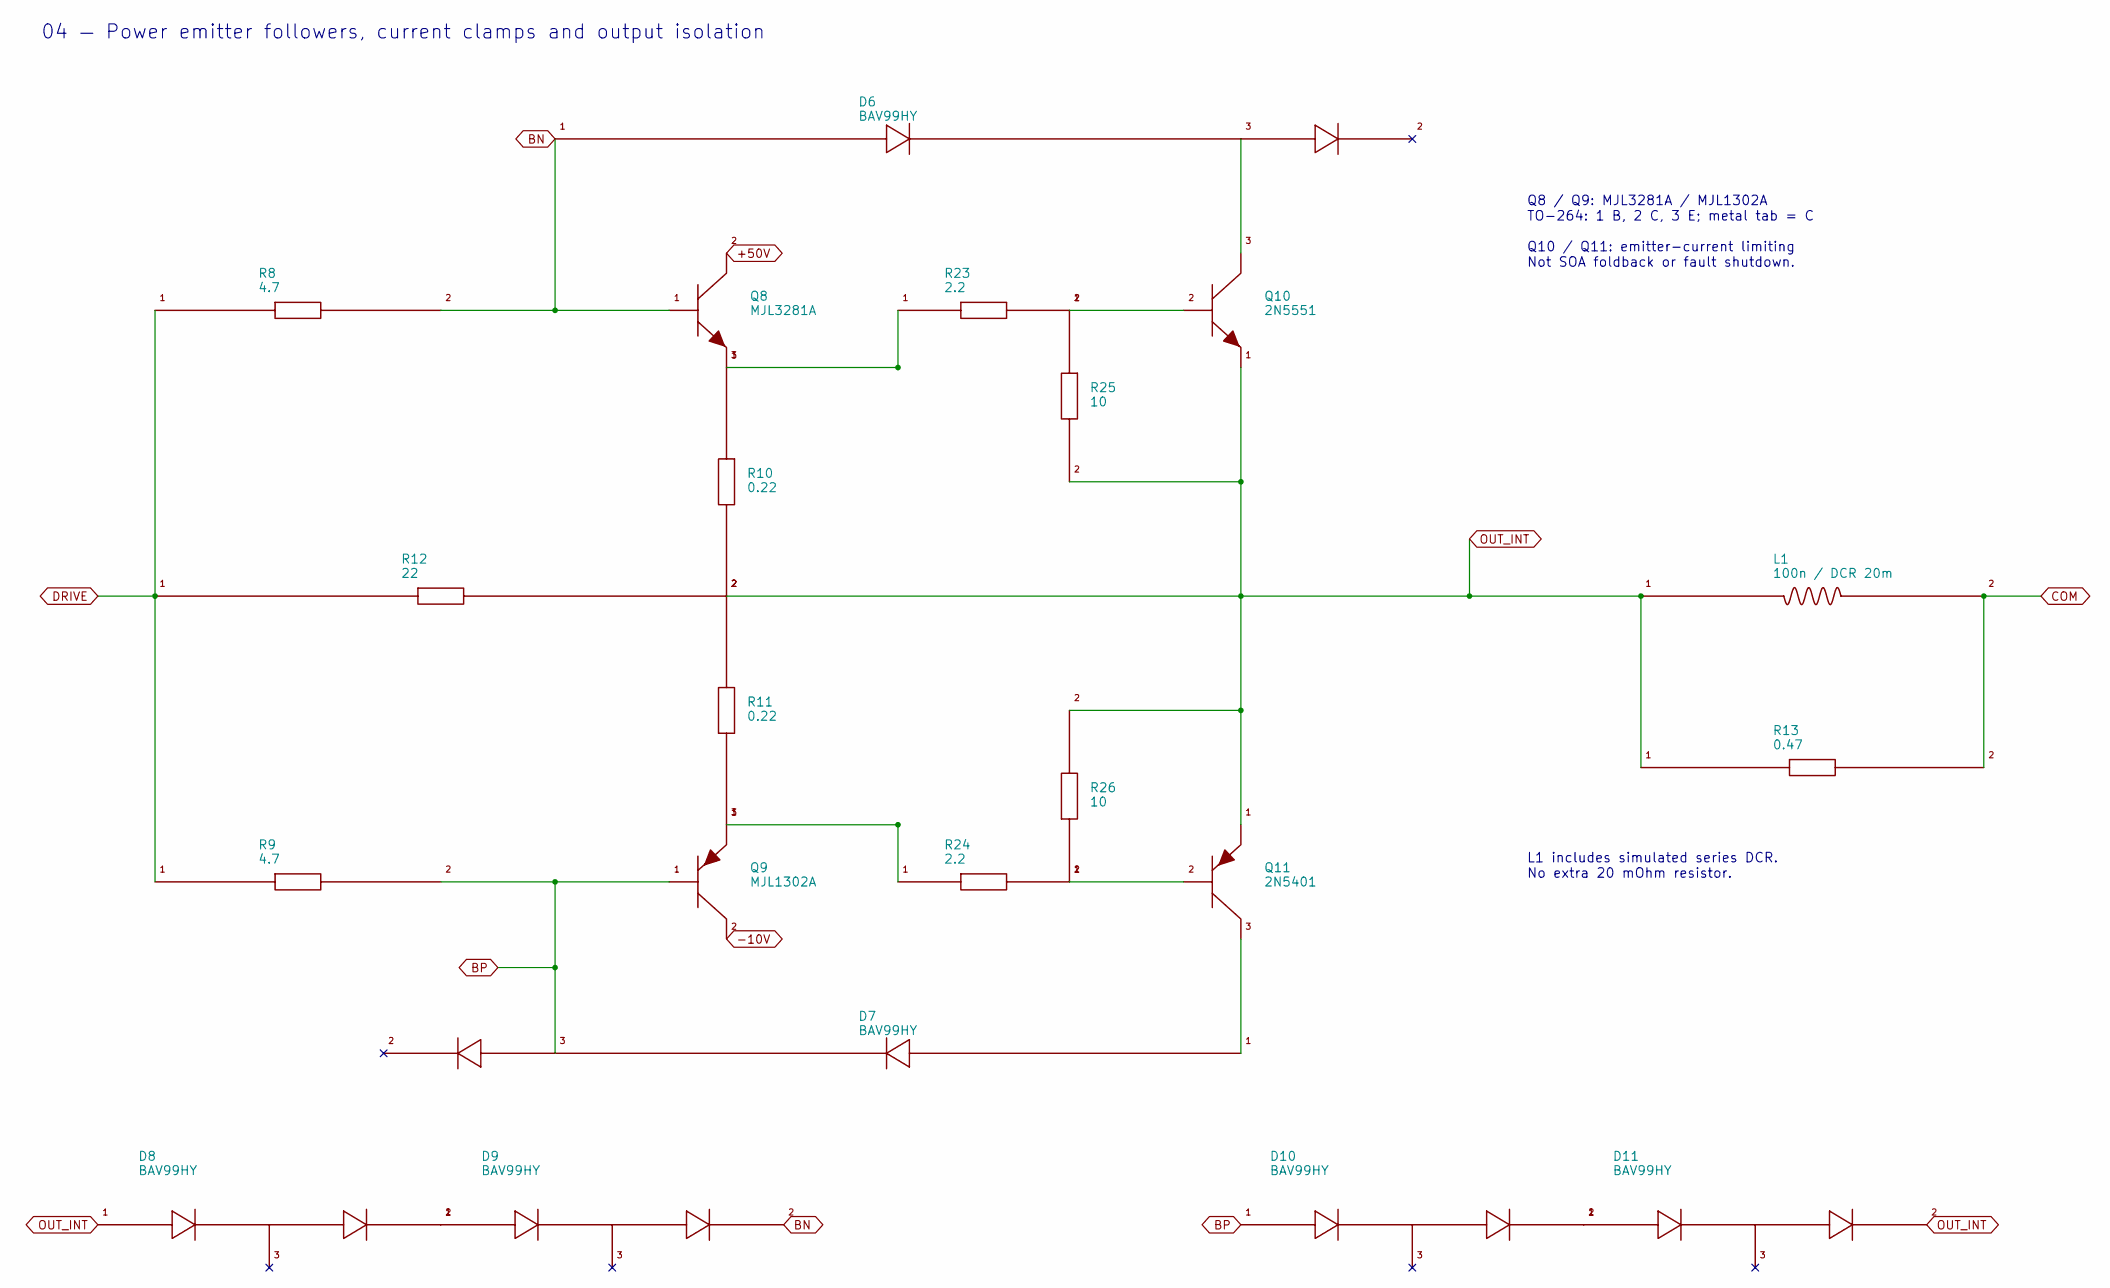
[picture p25: schematic power.kicad_sch]

Parts:
D6, D7, D8, D9, D10, D11: BAV99HY; SOT-23
L1: 100n / DCR 20m
Q8: MJL3281A; TO-264-3_Vertical
Q9: MJL1302A; TO-264-3_Vertical
Q10: 2N5551; TO-92_Inline
Q11: 2N5401; TO-92_Inline
R8, R9: 4.7
R10, R11: 0.22
R12: 22
R13: 0.47
R23, R24: 2.2
R25, R26: 10

Connections:
+50V: Q8.2 (C)
-10V: Q9.2 (C)
BN: D6.1, D9.2, Q8.1 (B), R8.2
BP: D7.3, D10.1, Q9.1 (B), R9.2
COM: L1.2, R13.2
DRIVE: R8.1, R9.1, R12.1
unnamed: D6.3, Q10.3 (C)
unnamed: D7.1, Q11.3 (C)
unnamed: D8.2, D9.1
unnamed: D10.2, D11.1
unnamed: Q8.3 (E), R10.1, R23.1
unnamed: Q9.3 (E), R11.1, R24.1
unnamed: Q10.2 (B), R23.2, R25.1
unnamed: Q11.2 (B), R24.2, R26.1
OUT_INT: D8.1, D11.2, L1.1, Q10.1 (E), Q11.1 (E), R10.2, R11.2, R12.2, R13.1, R25.2, R26.2

Notes on the sheet:
04 — Power emitter followers, current clamps and output isolation
Q8 / Q9: MJL3281A / MJL1302A TO-264: 1 B, 2 C, 3 E; metal tab = C Q10 / Q11: emitter-current limiting Not SOA foldback or fault shutdown.
L1 includes simulated series DCR. No extra 20 mOhm resistor.
