ttoomat/work-2026-itmo/DNA/class_B/AI/kicad/vas.kicad_sch

## KiCad design DNA/class_B/AI/kicad/vas.kicad_sch (2026-10-29)

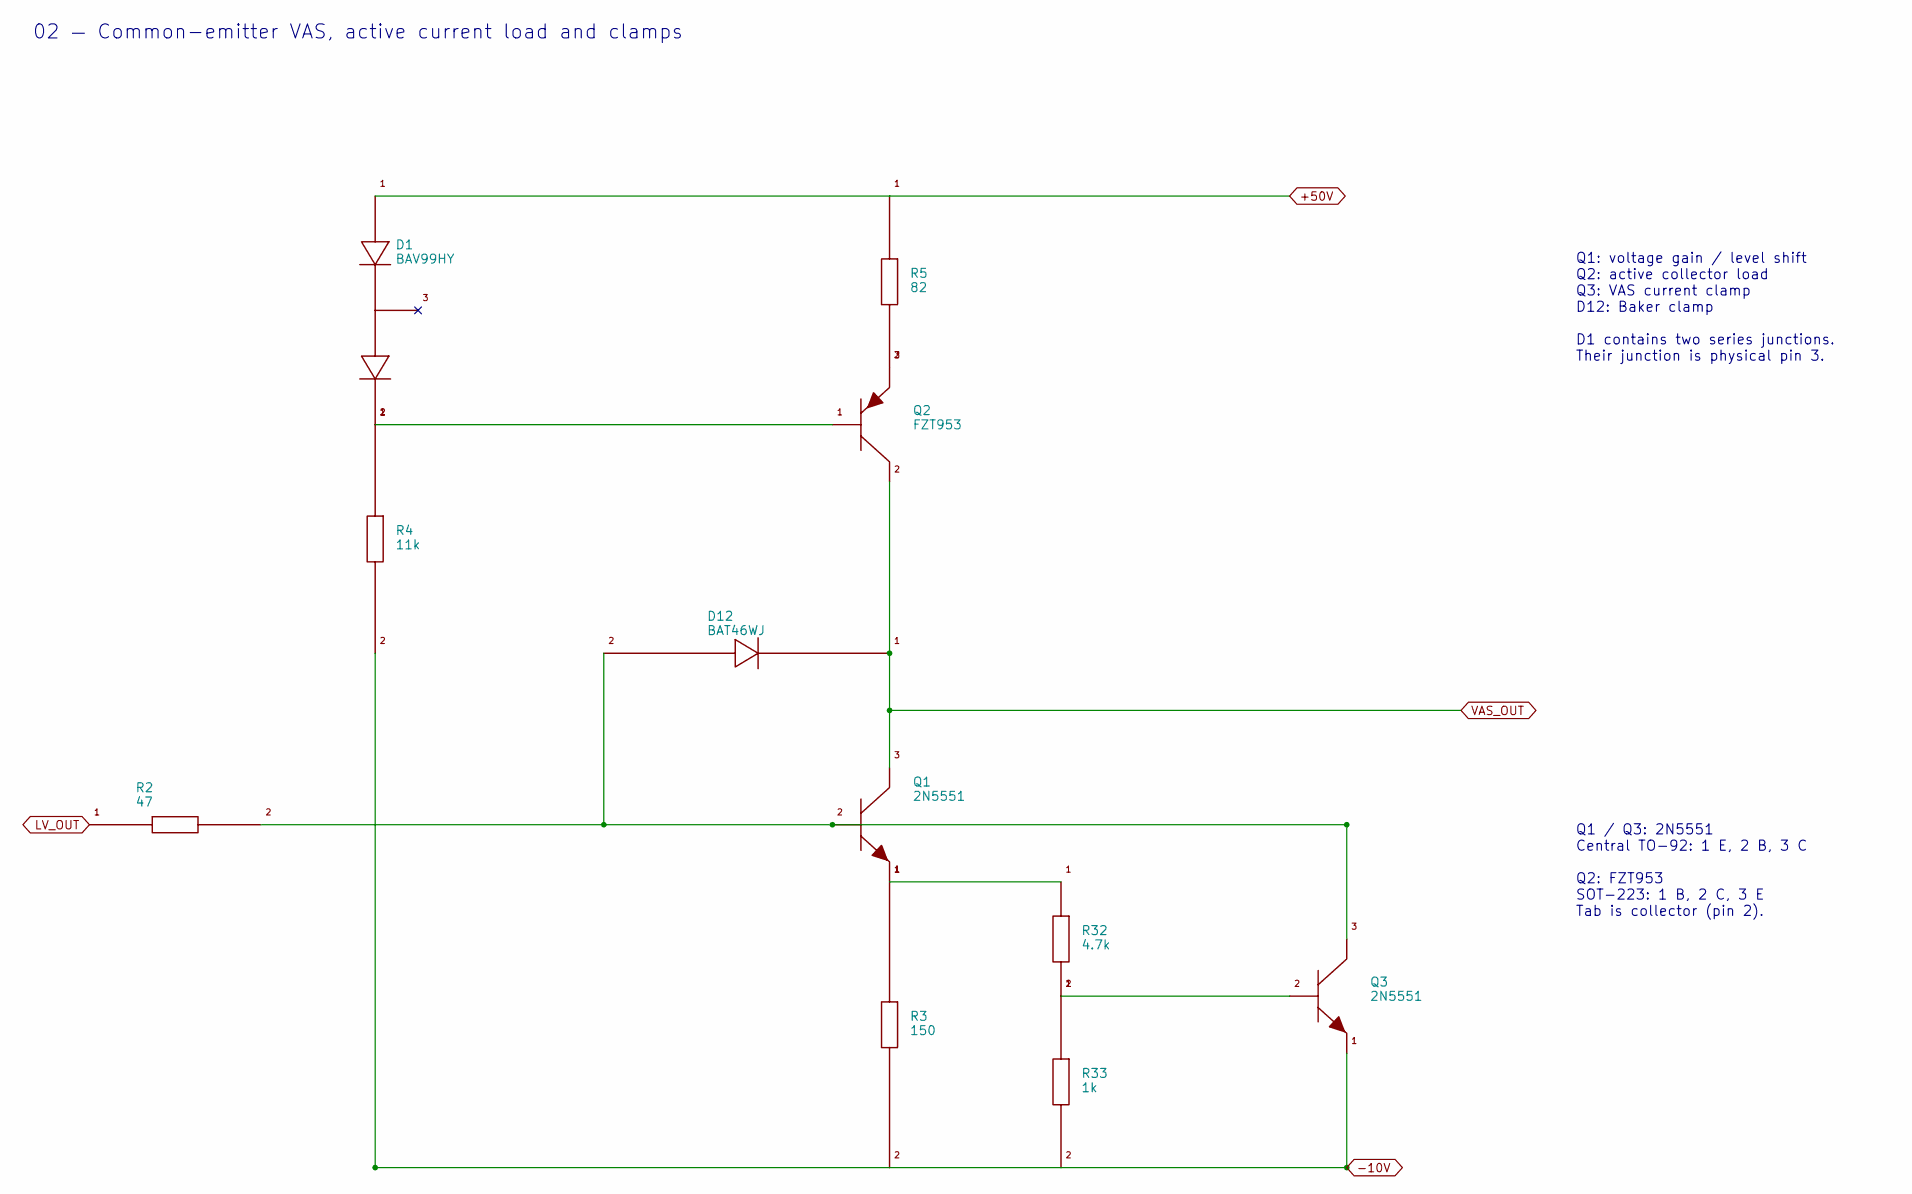
[picture p26: schematic vas.kicad_sch]

Parts:
D1: BAV99HY; SOT-23
D12: BAT46WJ; D_SOD-323F
Q1, Q3: 2N5551; TO-92_Inline
Q2: FZT953; SOT-223-3_TabPin2
R2: 47
R3: 150
R4: 11k
R5: 82
R32: 4.7k
R33: 1k

Connections:
+50V: D1.1, R5.1
-10V: Q3.1 (E), R3.2, R4.2, R33.2
LV_OUT: R2.1
unnamed: D1.2, Q2.1 (B), R4.1
unnamed: D12.2, Q1.2 (B), Q3.3 (C), R2.2
unnamed: Q1.1 (E), R3.1, R32.1
unnamed: Q2.3 (E), R5.2
unnamed: Q3.2 (B), R32.2, R33.1
VAS_OUT: D12.1, Q1.3 (C), Q2.2 (C)

Notes on the sheet:
02 — Common-emitter VAS, active current load and clamps
Q1: voltage gain / level shift Q2: active collector load Q3: VAS current clamp D12: Baker clamp D1 contains two series junctions. Their junction is physical pin 3.
Q1 / Q3: 2N5551 Central TO-92: 1 E, 2 B, 3 C Q2: FZT953 SOT-223: 1 B, 2 C, 3 E Tab is collector (pin 2).
