ttoomat/work-2026-itmo/(commit log)

2026-10-29 [DNA]: amplifier class B schematics 1.5/4 redrawn.
2026-10-30 [DNA]: all the schematics for Class B amplifier is ready.
    TODO: 1. Add resistors', capacitors' values. 2. Add all footprints for resistors and connectors.
2026-10-30 [DNA]: amplifier class D schematics start.
2026-10-30 [DNA]: class D, more of schematics added.
2026-10-31 [DNA]: class B, resistor values etc added.
2026-11-05 [DNA]: class B, LTSpice modeling, OpAmp stage works perfect.
2026-11-05 [DNA]: class B, LTSpice modeling, OpAmp stage: filters like in original schematics added.
    However, comparing model and original AI schematics, in negative feedback capacitor position was changed.
2026-11-06 [DNA]: class B, LTSpice modeling, correct offset. Plus KiCad edited.
2026-11-09 [DNA]: LTSpice model: 2nd step amplifies voltage by 5 times.
    There were problems with Math, bcs for big Ib1 we have Ie1 unequal (betta1 + 1)Ib1.
